leevawns/WHC512/main_v10/README.txt

void clearport(int port){
  id_card = (port-1)/64;
  id_ic = ((port-1)%64)/16;
  id_pin = (((port-1)%64)%16)+1;
  switch (id_card){
    case 0: 
      switch(id_ic){
      case 0: chip1.digitalWrite(0);chip1.pinMode(0); 
               break;
      case 1:  chip2.digitalWrite(0);chip2.pinMode(0);
               break;
      case 2:  chip3.digitalWrite(0);chip3.pinMode(0);
               break;
      case 3:  chip4.digitalWrite(0);chip4.pinMode(0);
         break;

      default:
         break;
        }break;
    case 1:
      switch(id_ic){
      case 0:  chip5.digitalWrite(0);chip5.pinMode(0);
               break;
      case 1: chip6.digitalWrite(0);chip6.pinMode(0); 
               break;
      case 2: chip7.digitalWrite(0);chip7.pinMode(0); 
               break;
      case 3: chip8.digitalWrite(0);chip8.pinMode(0); 
         break;
      default:
         break;    
    }break;
    case 2:
      switch(id_ic){
      case 0:  chip9.digitalWrite(0);chip9.pinMode(0);
               break;
      case 1: chip10.digitalWrite(0);chip10.pinMode(0); 
               break;
      case 2: chip11.digitalWrite(0);chip11.pinMode(0); 
               break;
      case 3: chip12.digitalWrite(0);chip12.pinMode(0); 
               break;
      default:
         break;    
    }break;
    case 3:
      switch(id_ic){
      case 0:  chip13.digitalWrite(0);chip13.pinMode(0);
               break;
      case 1: chip14.digitalWrite(0);chip14.pinMode(0); 
               break;
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
    }break;
    case 14:
      switch(id_ic){
       case 0:  chip57.digitalWrite(0);chip57.pinMode(0);
               break;
      case 1: chip58.digitalWrite(0);chip58.pinMode(0); 
               break;
      case 2: chip59.digitalWrite(0);chip59.pinMode(0); 
               break;
      case 3: chip60.digitalWrite(0);chip60.pinMode(0); 
               break;
        default:
         break;    
    }break;
    case 15:
      switch(id_ic){
      case 0:  chip61.digitalWrite(0);chip61.pinMode(0);
               break;
      case 1: chip62.digitalWrite(0);chip62.pinMode(0); 
               break;
      case 2: chip63.digitalWrite(0);chip63.pinMode(0); 
               break;
      case 3: chip64.digitalWrite(0);chip64.pinMode(0); 
               break;
      default:
               break;   
    }   */
default:
         break;     
  }
}
