leevawns/WHC512/PCB DESIGN BY A.CHUNG/HarnessChecker Pin Define.xlsx

Asignment of the I/O pins
STT | PIN No. | PIN Name | Speed | Direction | Initial state | Function | Connect to/from | Description
1 | 41 | PE5 | O1 | O | Push pull | Enable Card IO1 | PCB2 | L active
2 | 42 | PC0 | O1 | O | Push pull | Enable Card IO2 |  | L active
3 | 43 | PC1 | O3 | O | Push pull | Enable Card IO3 |  | L active
4 | 44 | PC2 | O3 | O | Push pull | Enable Card IO4 |  | L active
5 | 45 | PC3 | O3 | O | Push pull | Enable Card IO5 |  | L active
6 | 46 | PC4 | O3 | O | Push pull | Enable Card IO6 |  | L active
7 | 52 | PG0 | O1 | O | Push pull | Enable Card IO7 |  | L active
8 | 53 | PG1 | O1 | O | Push pull | Enable Card IO8 |  | L active
9 | 54 | PG2 | O1 | O | Push pull | Enable Card IO9 |  | L active
10 | 55 | PG3 | O1 | O | Push pull | Enable Card IO10 |  | L active
11 | 56 | PG4 | O1 | O | Push pull | Enable Card IO11 |  | L active
12 | 57 | PI0 | O1 | O | Push pull | Enable Card IO12 |  | L active
13 | 58 | PI1 | O1 | O | Push pull | Enable Card IO13 |  | L active
14 | 59 | PI2 | O1 | O | Push pull | Enable Card IO14 |  | L active
15 | 60 | PI3 | O1 | O | Push pull | Enable Card IO15 |  | L active
16 | 61 | PI4 | O1 | O | Push pull | Enable Card IO16 |  | L active
17 | 80 | PD7 |  | I | Wpu | Interrupt Card IO1 | PCB2 | H active
18 | 79 | PD6 |  | I | Wpu | Interrupt Card IO2 |  | H active
19 | 78 | PD5 |  | I | Wpu | Interrupt Card IO3 |  | H active
20 | 77 | PD4 |  | I | Wpu | Interrupt Card IO4 |  | H active
21 | 76 | PD3 |  | I | Wpu | Interrupt Card IO5 |  | H active
22 | 75 | PD2 |  | I | Wpu | Interrupt Card IO6 |  | H active
23 | 73 | PD0 |  | I | Wpu | Interrupt Card IO7 |  | H active
24 | 72 | PI7 |  | I | Wpu | Interrupt Card IO8 |  | H active
25 | 71 | PI6 |  | I | Wpu | Interrupt Card IO9 |  | H active
26 | 70 | PE0 |  | I | Wpu | Interrupt Card IO10 |  | H active
27 | 67 | PE3 |  | I | Wpu | Interrupt Card IO11 |  | H active
28 | 66 | PE4 |  | I | Wpu | Interrupt Card IO12 |  | H active
29 | 65 | PG7 |  | I | Wpu | Interrupt Card IO13 |  | H active
30 | 64 | PG6 |  | I | Wpu | Interrupt Card IO14 |  | H active
31 | 63 | PG5 |  | I | Wpu | Interrupt Card IO15 |  | H active
32 | 62 | PI5 |  | I | Wpu | Interrupt Card IO16 |  | H active
33 | 69 | PE1/I2C_SCL |  | O |  | I2C Clock | I2C Communication
34 | 68 | PE2/I2C_SDA |  | I/O |  | I2C Data
35 | 47 | PC5/SPI_SCK |  | O |  | SPI Clock | SPI Communication
36 | 50 | PC6/SPI_MOSI |  | O |  | SPI Master out/Slave in
37 | 51 | PC7/SPI_MISO |  | I |  | SPI Master in/Slave out
38 | 26 | PF0 | O1 | O | Push pull | Tape Control 1 | Tape | H active
39 | 27 | PB7 | O1 | O | Push pull | Tape Control 2 |  | H active
40 | 10 | PA4/USART_RX |  | I |  | USART receive | PC
41 | 11 | PA5/USART_TX |  | O |  | USART transmit
42 | 13 | PH0 | O3 | O | Push pull | Buzzer | PIN searh function | L active
43 | 14 | PH1 | O3 | I | Wpu | SW1 - Enter Pin search function |  | L active
44 | 15 | PH2 | O1 | O | Push pull | LED |  | H active
45 | 16 | PH3 | O1 | O | Push pull | Control Pin search function |  | L active
46 | 17 | PF7 | O1 | O |  | SPI1_SCK | SRAM - SPI Software
47 | 18 | PF6 | O1 | O |  | SPI1_SI
48 | 19 | PF5 |  | I |  | SPI1_SO
49 | 20 | PF4 | O1 | O |  | SPI1_CS |  | L active
50 | 28 | PB6 |  | I/O |  | Reserved
51 | 29 | PB5 |  | I/O
52 | 30 | PB4 |  | I/O
53 | 31 | PB3 |  | I/O
54 | 32 | PB2 |  | I/O
55 | 33 | PB1 |  | I/O
56 | 34 | PB0 |  | I/O
57 | 35 | PH4 |  | I/O
58 | 36 | PH5 |  | I/O
59 | 37 | PH6 |  | I/O
60 | 38 | PH7 |  | I/O
61 | 39 | PE7 |  | I/O
62 | 40 | PE6 |  | I/O
Output Speed:
O1 = Standard (up to 2MHz)
O3 = Fast/slow programmability with slow as default state after reset
