leevawns/WHC512/PCB DESIGN BY A.CHUNG/PartList_IOCar_64bit.xlsx

STT | Part Name | Reference Designator | Value | Tolerance | MAX Voltage | Chip Set | Maker | component kind | Quantity | Số lượng linh kiện trên 1 card
1 | GCM188R11C104JA01D | C1 | 0.1u | 5% | 16V | 1608 | Murata | Capacitor | 16 | GCM188R11C104JA01D | 16 | Tụ Ceramic 100nF / 50V / 0603
2 | GCM188R11C104JA01D | C2 | 0.1u | 5% | 16V | 1608 | Murata | Capacitor |  | 16SKV10M4*5.5 | 1 | Tụ nhôm 10uF / 16V
3 | GCM188R11C104JA01D | C3 | 0.1u | 5% | 16V | 1608 | Murata | Capacitor |  | MLZ2012M4R7W | 2
4 | GCM188R11C104JA01D | C4 | 0.1u | 5% | 16V | 1608 | Murata | Capacitor |  | FMN1T148 | 16
5 | GCM188R11C104JA01D | C5 | 0.1u | 5% | 16V | 1608 | Murata | Capacitor |  | FMP1T148 | 16
6 | GCM188R11C104JA01D | C6 | 0.1u | 5% | 16V | 1608 | Murata | Capacitor |  | MCP23S17-E/SO | 4
7 | GCM188R11C104JA01D | C7 | 0.1u | 5% | 16V | 1608 | Murata | Capacitor |  | CR1/16473JV | 24 | Điện trở 47k / 0603
8 | GCM188R11C104JA01D | C8 | 0.1u | 5% | 16V | 1608 | Murata | Capacitor |  | CR1/16103JV | 4 | Điện trở 10k / 0603
9 | GCM188R11C104JA01D | C9 | 0.1u | 5% | 16V | 1608 | Murata | Capacitor |  | CR1/16472JV | 64 | Điệntrở 4.7k / 0603
10 | GCM188R11C104JA01D | C10 | 0.1u | 5% | 16V | 1608 | Murata | Capacitor |  | PCN10-16P-2.54DS(72) | 1
11 | GCM188R11C104JA01D | C11 | 0.1u | 5% | 16V | 1608 | Murata | Capacitor |  | XG4A-6434 | 1
12 | GCM188R11C104JA01D | C12 | 0.1u | 5% | 16V | 1608 | Murata | Capacitor |  | 4816P-1-101LF | 8
13 | GCM188R11C104JA01D | C13 | 0.1u | 5% | 16V | 1608 | Murata | Capacitor
14 | GCM188R11C104JA01D | C14 | 0.1u | 5% | 16V | 1608 | Murata | Capacitor
15 | GCM188R11C104JA01D | C15 | 0.1u | 5% | 16V | 1608 | Murata | Capacitor
16 | GCM188R11C104JA01D | C16 | 0.1u | 5% | 16V | 1608 | Murata | Capacitor
17 | 16SKV10M4*5.5 | C17 | 10u | ・\ | 16V | ・\ | Rubicon | Capacitor | 0
18 | MLZ2012M4R7W | L1 | 4.7uH | 20% | - | 2125 | TDK | Coil | 2
19 | MLZ2012M4R7W | L2 | 4.7uH | 20% | - | 2125 | TDK | Coil
20 | FMN1T148 | D10A |  |  |  | SC-74A | Rohm | Diode | 16
21 | FMP1T148 | D10B |  |  |  | SC-74A | Rohm | Diode | 16
22 | FMN1T148 | D11A |  |  |  | SC-74A | Rohm | Diode | 16
23 | FMP1T148 | D11B |  |  |  | SC-74A | Rohm | Diode
24 | FMN1T148 | D12A |  |  |  | SC-74A | Rohm | Diode
25 | FMP1T148 | D12B |  |  |  | SC-74A | Rohm | Diode
26 | FMN1T148 | D13A |  |  |  | SC-74A | Rohm | Diode
27 | FMP1T148 | D13B |  |  |  | SC-74A | Rohm | Diode
28 | FMN1T148 | D14A |  |  |  | SC-74A | Rohm | Diode
29 | FMP1T148 | D14B |  |  |  | SC-74A | Rohm | Diode
30 | FMN1T148 | D15A |  |  |  | SC-74A | Rohm | Diode
31 | FMP1T148 | D15B |  |  |  | SC-74A | Rohm | Diode
32 | FMN1T148 | D16A |  |  |  | SC-74A | Rohm | Diode
33 | FMP1T148 | D16B |  |  |  | SC-74A | Rohm | Diode
34 | FMN1T148 | D1A |  |  |  | SC-74A | Rohm | Diode
35 | FMP1T148 | D1B |  |  |  | SC-74A | Rohm | Diode
36 | FMN1T148 | D2A |  |  |  | SC-74A | Rohm | Diode
37 | FMP1T148 | D2B |  |  |  | SC-74A | Rohm | Diode
38 | FMN1T148 | D3A |  |  |  | SC-74A | Rohm | Diode
39 | FMP1T148 | D3B |  |  |  | SC-74A | Rohm | Diode
40 | FMN1T148 | D4A |  |  |  | SC-74A | Rohm | Diode
41 | FMP1T148 | D4B |  |  |  | SC-74A | Rohm | Diode
42 | FMN1T148 | D5A |  |  |  | SC-74A | Rohm | Diode
43 | FMP1T148 | D5B |  |  |  | SC-74A | Rohm | Diode
44 | FMN1T148 | D6A |  |  |  | SC-74A | Rohm | Diode
45 | FMP1T148 | D6B |  |  |  | SC-74A | Rohm | Diode
46 | FMN1T148 | D7A |  |  |  | SC-74A | Rohm | Diode
47 | FMP1T148 | D7B |  |  |  | SC-74A | Rohm | Diode
48 | FMN1T148 | D8A |  |  |  | SC-74A | Rohm | Diode
49 | FMP1T148 | D8B |  |  |  | SC-74A | Rohm | Diode
50 | FMN1T148 | D9A |  |  |  | SC-74A | Rohm | Diode
51 | FMP1T148 | D9B |  |  |  | SC-74A | Rohm | Diode
52 | MCP23S17-E/SO | IC1 | - | - | - | SOIC | Microchip | IC | 4
53 | MCP23S17-E/SO | IC2 | - | - | - | SOIC | Microchip | IC
54 | MCP23S17-E/SO | IC3 | - | - | - | SOIC | Microchip | IC
55 | MCP23S17-E/SO | IC4 | - | - | - | SOIC | Microchip | IC
56 | CR1/16473JV | R1 | 47k | 5% | ・\ | 1608 | HOKURIKU | Resistor | 24
57 | CR1/16473JV | R2 | 47k | 5% | ・\ | 1608 | HOKURIKU | Resistor
58 | CR1/16473JV | R3 | 47k | 5% | ・\ | 1608 | HOKURIKU | Resistor
59 | CR1/16473JV | R4 | 47k | 5% | ・\ | 1608 | HOKURIKU | Resistor
60 | CR1/16473JV | R5 | 47k | 5% | ・\ | 1608 | HOKURIKU | Resistor
61 | CR1/16473JV | R6 | 47k | 5% | ・\ | 1608 | HOKURIKU | Resistor
62 | CR1/16473JV | R7 | 47k | 5% | ・\ | 1608 | HOKURIKU | Resistor
63 | CR1/16473JV | R8 | 47k | 5% | ・\ | 1608 | HOKURIKU | Resistor
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
124 | CR1/16472JV | R69 | 4.7k | 5% | 50V | 1608 | HOKURIKU | Resistor
125 | CR1/16472JV | R70 | 4.7k | 5% | 50V | 1608 | HOKURIKU | Resistor
126 | CR1/16472JV | R71 | 4.7k | 5% | 50V | 1608 | HOKURIKU | Resistor
127 | CR1/16472JV | R72 | 4.7k | 5% | 50V | 1608 | HOKURIKU | Resistor
128 | CR1/16472JV | R73 | 4.7k | 5% | 50V | 1608 | HOKURIKU | Resistor
129 | CR1/16472JV | R74 | 4.7k | 5% | 50V | 1608 | HOKURIKU | Resistor
130 | CR1/16472JV | R75 | 4.7k | 5% | 50V | 1608 | HOKURIKU | Resistor
131 | CR1/16472JV | R76 | 4.7k | 5% | 50V | 1608 | HOKURIKU | Resistor
132 | CR1/16472JV | R77 | 4.7k | 5% | 50V | 1608 | HOKURIKU | Resistor
133 | CR1/16472JV | R78 | 4.7k | 5% | 50V | 1608 | HOKURIKU | Resistor
134 | CR1/16472JV | R79 | 4.7k | 5% | 50V | 1608 | HOKURIKU | Resistor
135 | CR1/16472JV | R80 | 4.7k | 5% | 50V | 1608 | HOKURIKU | Resistor
136 | CR1/16472JV | R81 | 4.7k | 5% | 50V | 1608 | HOKURIKU | Resistor
137 | CR1/16472JV | R82 | 4.7k | 5% | 50V | 1608 | HOKURIKU | Resistor
138 | CR1/16472JV | R83 | 4.7k | 5% | 50V | 1608 | HOKURIKU | Resistor
139 | CR1/16472JV | R84 | 4.7k | 5% | 50V | 1608 | HOKURIKU | Resistor
140 | CR1/16472JV | R85 | 4.7k | 5% | 50V | 1608 | HOKURIKU | Resistor
141 | CR1/16472JV | R86 | 4.7k | 5% | 50V | 1608 | HOKURIKU | Resistor
142 | CR1/16472JV | R87 | 4.7k | 5% | 50V | 1608 | HOKURIKU | Resistor
143 | CR1/16472JV | R88 | 4.7k | 5% | 50V | 1608 | HOKURIKU | Resistor
144 | CR1/16472JV | R89 | 4.7k | 5% | 50V | 1608 | HOKURIKU | Resistor
145 | CR1/16472JV | R90 | 4.7k | 5% | 50V | 1608 | HOKURIKU | Resistor
146 | CR1/16472JV | R91 | 4.7k | 5% | 50V | 1608 | HOKURIKU | Resistor
147 | CR1/16472JV | R92 | 4.7k | 5% | 50V | 1608 | HOKURIKU | Resistor
148 | PCN10-16P-2.54DS(72) | CN1 |  |  |  |  | HIROSE | Connector | 1
149 | XG4A-6434 | CN2 | ・\ | ・\ | ・\ | ・\ | OMRON | Connector | 1
150 | 4816P-1-101LF | RA1 | 100 | 2% | - | - | BOURNS | Resistor | 8
151 | 4816P-1-101LF | RA2 | 100 | 2% | - | - | BOURNS | Resistor
152 | 4816P-1-101LF | RA3 | 100 | 2% | - | - | BOURNS | Resistor
153 | 4816P-1-101LF | RA4 | 100 | 2% | - | - | BOURNS | Resistor
154 | 4816P-1-101LF | RA5 | 100 | 2% | - | - | BOURNS | Resistor
155 | 4816P-1-101LF | RA6 | 100 | 2% | - | - | BOURNS | Resistor
156 | 4816P-1-101LF | RA7 | 100 | 2% | - | - | BOURNS | Resistor
157 | 4816P-1-101LF | RA8 | 100 | 2% | - | - | BOURNS | Resistor
