leevawns/WHC512/PCB DESIGN BY A.CHUNG/PartList_MAIN.xlsx

STT | Part Name | Reference Designator | Value | Tolerance | MAX Voltage | Chip Set | Maker | component kind | Quantity | Số lượng linh kiện trên 1 card
1 | GCM188R11C104JA01D | C2 | 0.1u | 5% | 16V | 1608 | Murata | Capacitor | 16 | GCM188R11C104JA01D | 16 | Tụ Ceramic 100nF / 50V / 0603
2 | GCM188R11C104JA01D | C6 | 0.1u | 5% | 16V | 1608 | Murata | Capacitor |  | EEEFK1C101P | 1 | Tụ nhôm 100uF /16V
3 | GCM188R11C104JA01D | C7 | 0.1u | 5% | 16V | 1608 | Murata | Capacitor |  | MCP23017-E/SO | 8
4 | GCM188R11C104JA01D | C13 | 0.1u | 5% | 16V | 1608 | Murata | Capacitor |  | CR1/16473JV | 24 | Điện trở 47k / 0603
5 | GCM188R11C104JA01D | C14 | 0.1u | 5% | 16V | 1608 | Murata | Capacitor |  | CR1/16103JV | 8 | Điện trở 10k / 0603
6 | GCM188R11C104JA01D | C18 | 0.1u | 5% | 16V | 1608 | Murata | Capacitor |  | 61204021621 | 1
7 | GCM188R11C104JA01D | C19 | 0.1u | 5% | 16V | 1608 | Murata | Capacitor |  | KLS1-2.54-02-S | 1
8 | GCM188R11C104JA01D | C21 | 0.1u | 5% | 16V | 1608 | Murata | Capacitor |  | 2-534206-0 | 1
9 | GCM188R11C104JA01D | C22 | 0.1u | 5% | 16V | 1608 | Murata | Capacitor |  | PCN10C-16S-2.54DSA(72) | 16
10 | GCM188R11C104JA01D | C24 | 0.1u | 5% | 16V | 1608 | Murata | Capacitor
11 | GCM188R11C104JA01D | C25 | 0.1u | 5% | 16V | 1608 | Murata | Capacitor
12 | GCM188R11C104JA01D | C26 | 0.1u | 5% | 16V | 1608 | Murata | Capacitor
13 | GCM188R11C104JA01D | C27 | 0.1u | 5% | 16V | 1608 | Murata | Capacitor
14 | GCM188R11C104JA01D | C32 | 0.1u | 5% | 16V | 1608 | Murata | Capacitor
15 | GCM188R11C104JA01D | C34 | 0.1u | 5% | 16V | 1608 | Murata | Capacitor
16 | GCM188R11C104JA01D | C37 | 0.1u | 5% | 16V | 1608 | Murata | Capacitor
17 | EEEFK1C101P | C38 | 100u | 20% | 16V | ・\ | Panasonic | Capacitor | 1
18 | MCP23017-E/SO | IC1 | - | - | - | SOIC | Microchip | IC | 8
19 | MCP23017-E/SO | IC2 | - | - | - | SOIC | Microchip | IC
20 | MCP23017-E/SO | IC3 | - | - | - | SOIC | Microchip | IC
21 | MCP23017-E/SO | IC4 | - | - | - | SOIC | Microchip | IC
22 | MCP23017-E/SO | IC5 | - | - | - | SOIC | Microchip | IC
23 | MCP23017-E/SO | IC6 | - | - | - | SOIC | Microchip | IC
24 | MCP23017-E/SO | IC7 | - | - | - | SOIC | Microchip | IC
25 | MCP23017-E/SO | IC8 | - | - | - | SOIC | Microchip | IC
26 | CR1/16473JV | R1 | 47k | 5% | ・\ | 1608 | HOKURIKU | Resistor | 24
27 | CR1/16473JV | R2 | 47k | 5% | ・\ | 1608 | HOKURIKU | Resistor
28 | CR1/16473JV | R3 | 47k | 5% | ・\ | 1608 | HOKURIKU | Resistor
29 | CR1/16103JV | R4 | 10k | 5% | 50V | 1608 | HOKURIKU | Resistor | 8
30 | CR1/16473JV | R5 | 47k | 5% | ・\ | 1608 | HOKURIKU | Resistor
31 | CR1/16473JV | R6 | 47k | 5% | ・\ | 1608 | HOKURIKU | Resistor
32 | CR1/16473JV | R7 | 47k | 5% | ・\ | 1608 | HOKURIKU | Resistor
33 | CR1/16103JV | R14 | 10k | 5% | 50V | 1608 | HOKURIKU | Resistor
34 | CR1/16473JV | R19 | 47k | 5% | ・\ | 1608 | HOKURIKU | Resistor
35 | CR1/16473JV | R20 | 47k | 5% | ・\ | 1608 | HOKURIKU | Resistor
36 | CR1/16473JV | R21 | 47k | 5% | ・\ | 1608 | HOKURIKU | Resistor
37 | CR1/16103JV | R24 | 10k | 5% | 50V | 1608 | HOKURIKU | Resistor
38 | CR1/16473JV | R29 | 47k | 5% | ・\ | 1608 | HOKURIKU | Resistor
39 | CR1/16473JV | R30 | 47k | 5% | ・\ | 1608 | HOKURIKU | Resistor
40 | CR1/16473JV | R31 | 47k | 5% | ・\ | 1608 | HOKURIKU | Resistor
41 | CR1/16103JV | R36 | 10k | 5% | 50V | 1608 | HOKURIKU | Resistor
42 | CR1/16473JV | R46 | 47k | 5% | ・\ | 1608 | HOKURIKU | Resistor
43 | CR1/16473JV | R47 | 47k | 5% | ・\ | 1608 | HOKURIKU | Resistor
44 | CR1/16473JV | R48 | 47k | 5% | ・\ | 1608 | HOKURIKU | Resistor
45 | CR1/16103JV | R64 | 10k | 5% | 50V | 1608 | HOKURIKU | Resistor
46 | CR1/16473JV | R65 | 47k | 5% | ・\ | 1608 | HOKURIKU | Resistor
47 | CR1/16473JV | R66 | 47k | 5% | ・\ | 1608 | HOKURIKU | Resistor
48 | CR1/16473JV | R67 | 47k | 5% | ・\ | 1608 | HOKURIKU | Resistor
49 | CR1/16103JV | R69 | 10k | 5% | 50V | 1608 | HOKURIKU | Resistor
50 | CR1/16473JV | R75 | 47k | 5% | ・\ | 1608 | HOKURIKU | Resistor
51 | CR1/16473JV | R76 | 47k | 5% | ・\ | 1608 | HOKURIKU | Resistor
52 | CR1/16473JV | R77 | 47k | 5% | ・\ | 1608 | HOKURIKU | Resistor
53 | CR1/16103JV | R78 | 10k | 5% | 50V | 1608 | HOKURIKU | Resistor
54 | CR1/16473JV | R79 | 47k | 5% | ・\ | 1608 | HOKURIKU | Resistor
55 | CR1/16473JV | R80 | 47k | 5% | ・\ | 1608 | HOKURIKU | Resistor
56 | CR1/16473JV | R81 | 47k | 5% | ・\ | 1608 | HOKURIKU | Resistor
57 | CR1/16103JV | R82 | 10k | 5% | 50V | 1608 | HOKURIKU | Resistor
58 | 61204021621 | CN1 | - | - | - | - | WURTH | Connector | 1
59 | KLS1-2.54-02-S | CN2 | - | - | - | - | KLS | Connector | 1
60 | 2-534206-0 | CN3 | - | - | - | - | TE | Connector | 1
61 | PCN10C-16S-2.54DSA(72) | P1 |  |  |  |  | HIROSE | Connector | 16
62 | PCN10C-16S-2.54DSA(72) | P2 |  |  |  |  | HIROSE | Connector
63 | PCN10C-16S-2.54DSA(72) | P3 |  |  |  |  | HIROSE | Connector
64 | PCN10C-16S-2.54DSA(72) | P4 |  |  |  |  | HIROSE | Connector
65 | PCN10C-16S-2.54DSA(72) | P5 |  |  |  |  | HIROSE | Connector
66 | PCN10C-16S-2.54DSA(72) | P6 |  |  |  |  | HIROSE | Connector
67 | PCN10C-16S-2.54DSA(72) | P7 |  |  |  |  | HIROSE | Connector
68 | PCN10C-16S-2.54DSA(72) | P8 |  |  |  |  | HIROSE | Connector
69 | PCN10C-16S-2.54DSA(72) | P9 |  |  |  |  | HIROSE | Connector
70 | PCN10C-16S-2.54DSA(72) | P10 |  |  |  |  | HIROSE | Connector
71 | PCN10C-16S-2.54DSA(72) | P11 |  |  |  |  | HIROSE | Connector
72 | PCN10C-16S-2.54DSA(72) | P12 |  |  |  |  | HIROSE | Connector
73 | PCN10C-16S-2.54DSA(72) | P13 |  |  |  |  | HIROSE | Connector
74 | PCN10C-16S-2.54DSA(72) | P14 |  |  |  |  | HIROSE | Connector
75 | PCN10C-16S-2.54DSA(72) | P15 |  |  |  |  | HIROSE | Connector
76 | PCN10C-16S-2.54DSA(72) | P16 |  |  |  |  | HIROSE | Connector
