leevawns/WHC512/PCB DESIGN BY A.CHUNG/PCB1-MCU.pdf

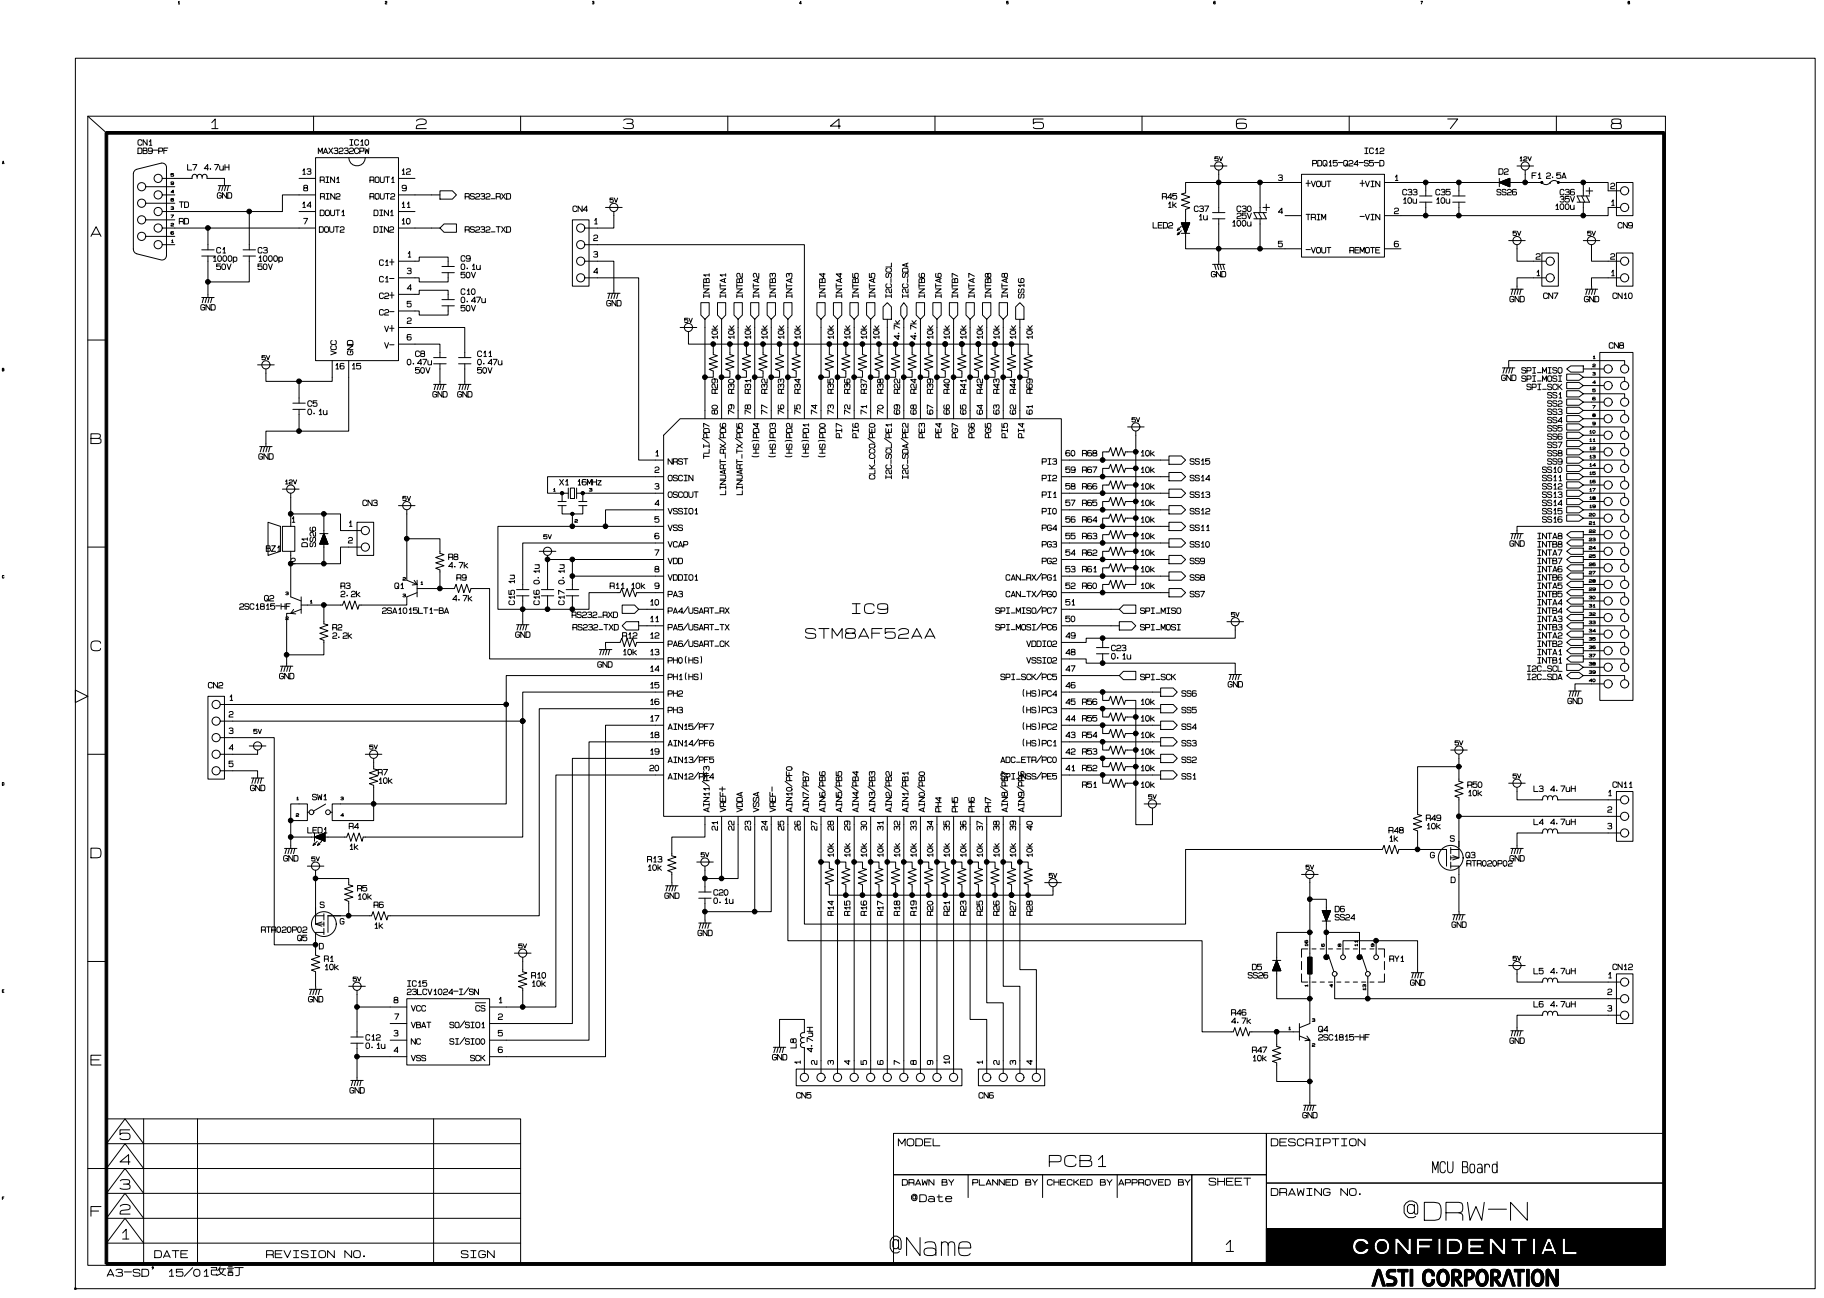
[picture p1: page 1]
