leevawns/WHC512/PCB DESIGN BY A.CHUNG/PCB2-Control.pdf

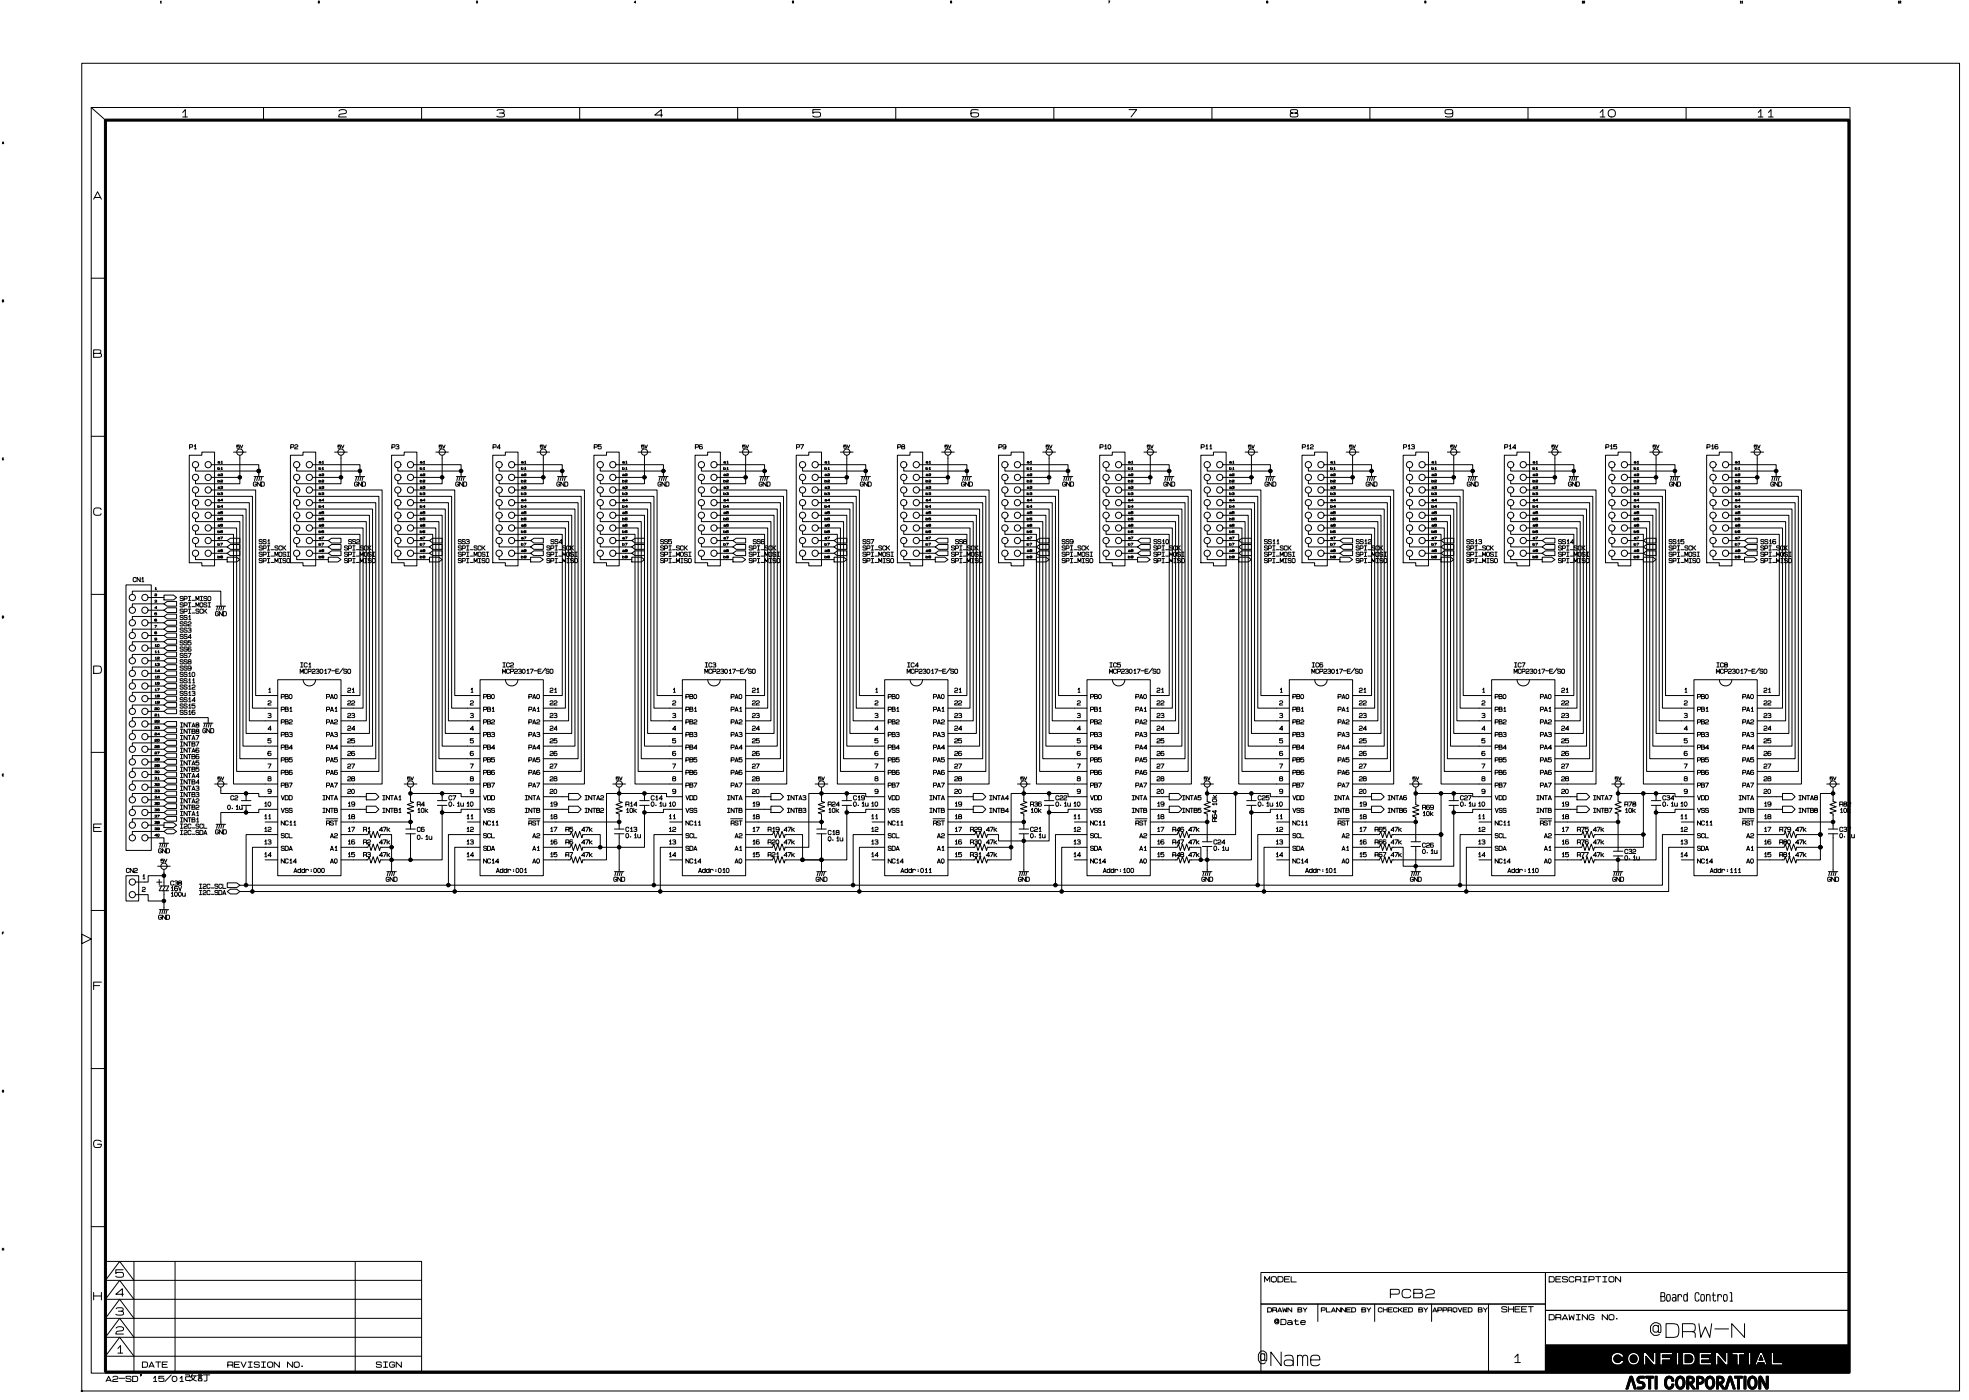
[picture p2: page 1]
