leevawns/WHC512/PCB DESIGN BY A.CHUNG/PCB3-Card IO 64Bit.pdf

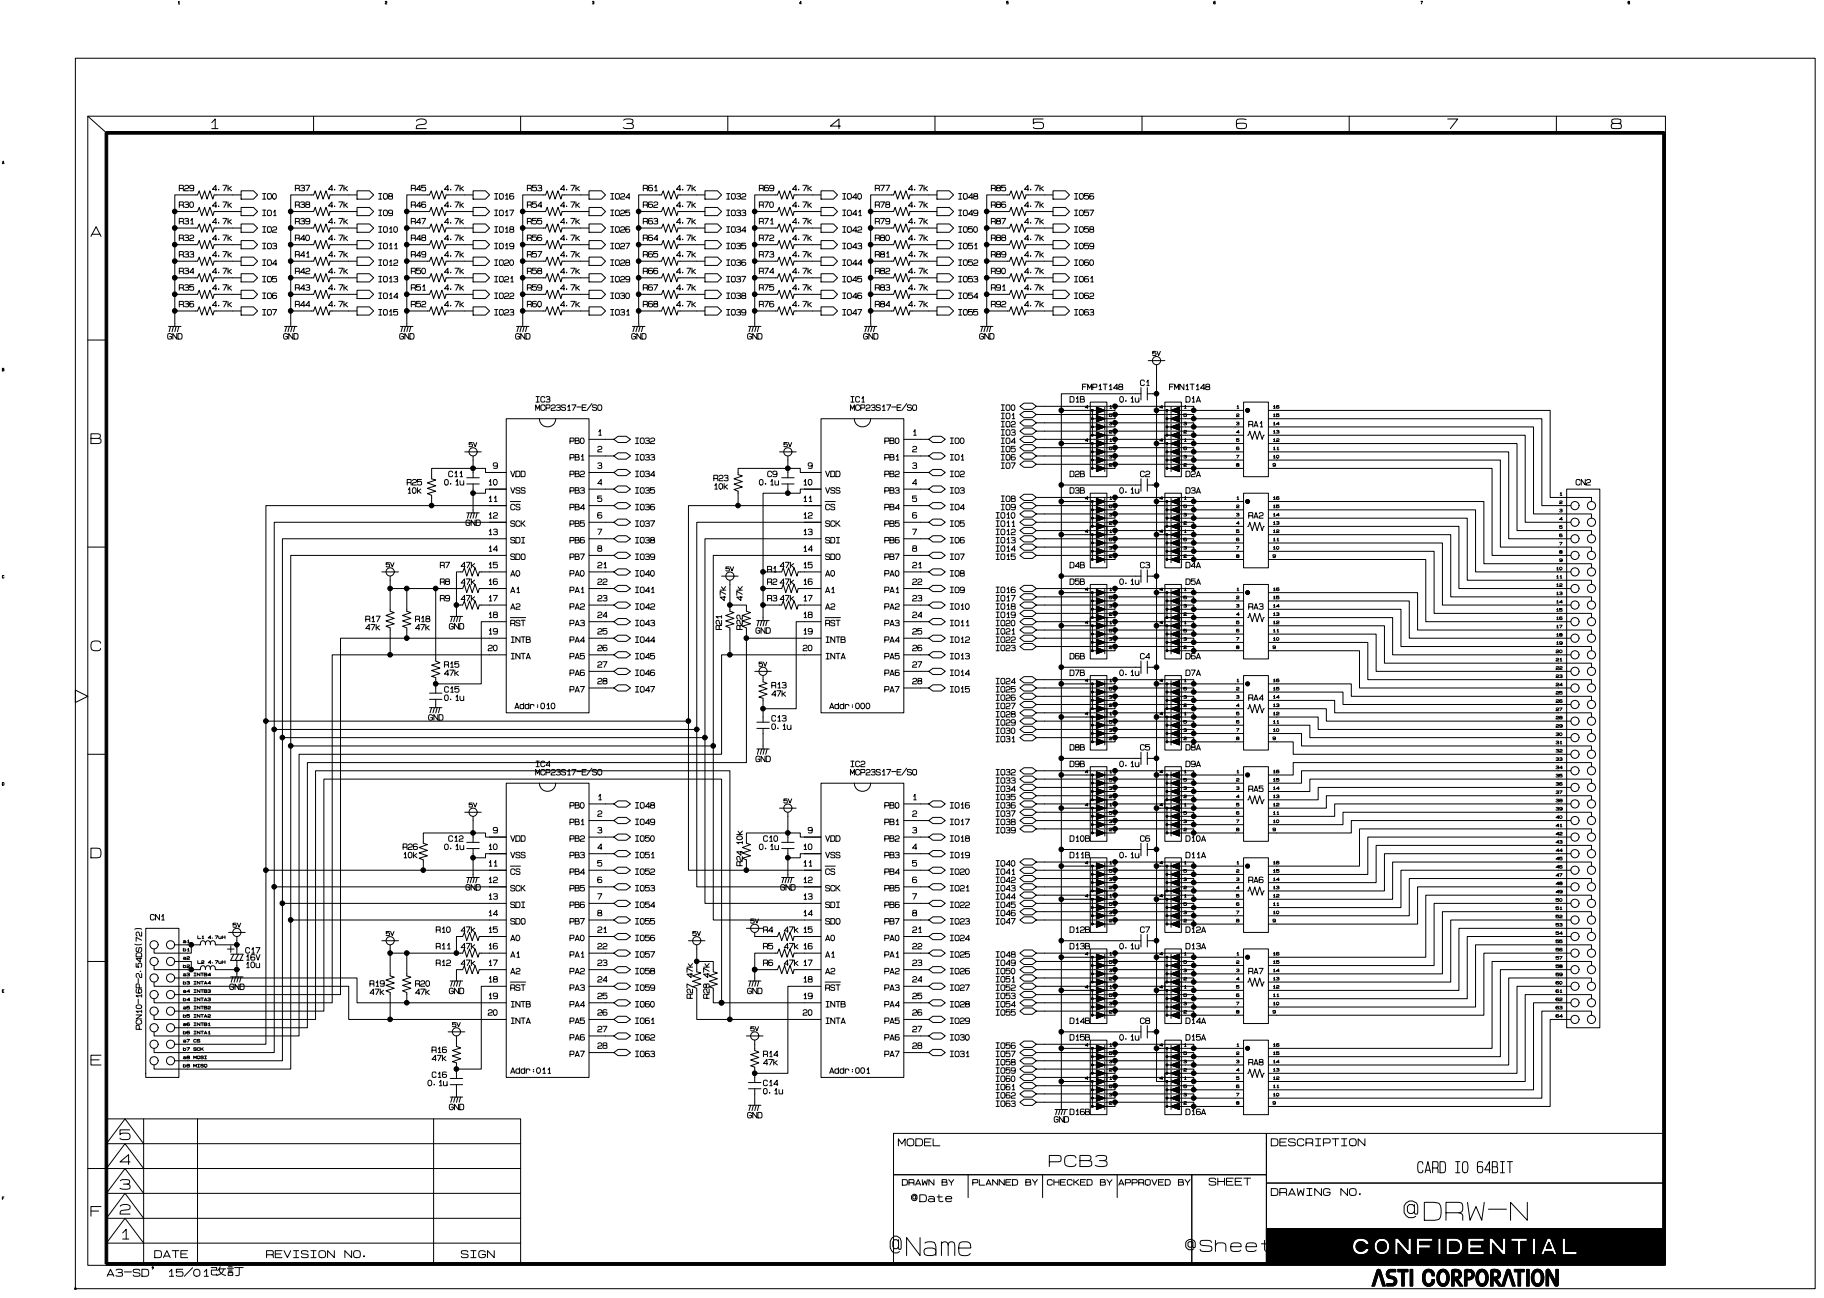
[picture p3: page 1]
