leevawns/WHC512/PCB DESIGN BY A.CHUNG/Wire harness schematic - v2/Arduino_Mega2560_R5.pdf

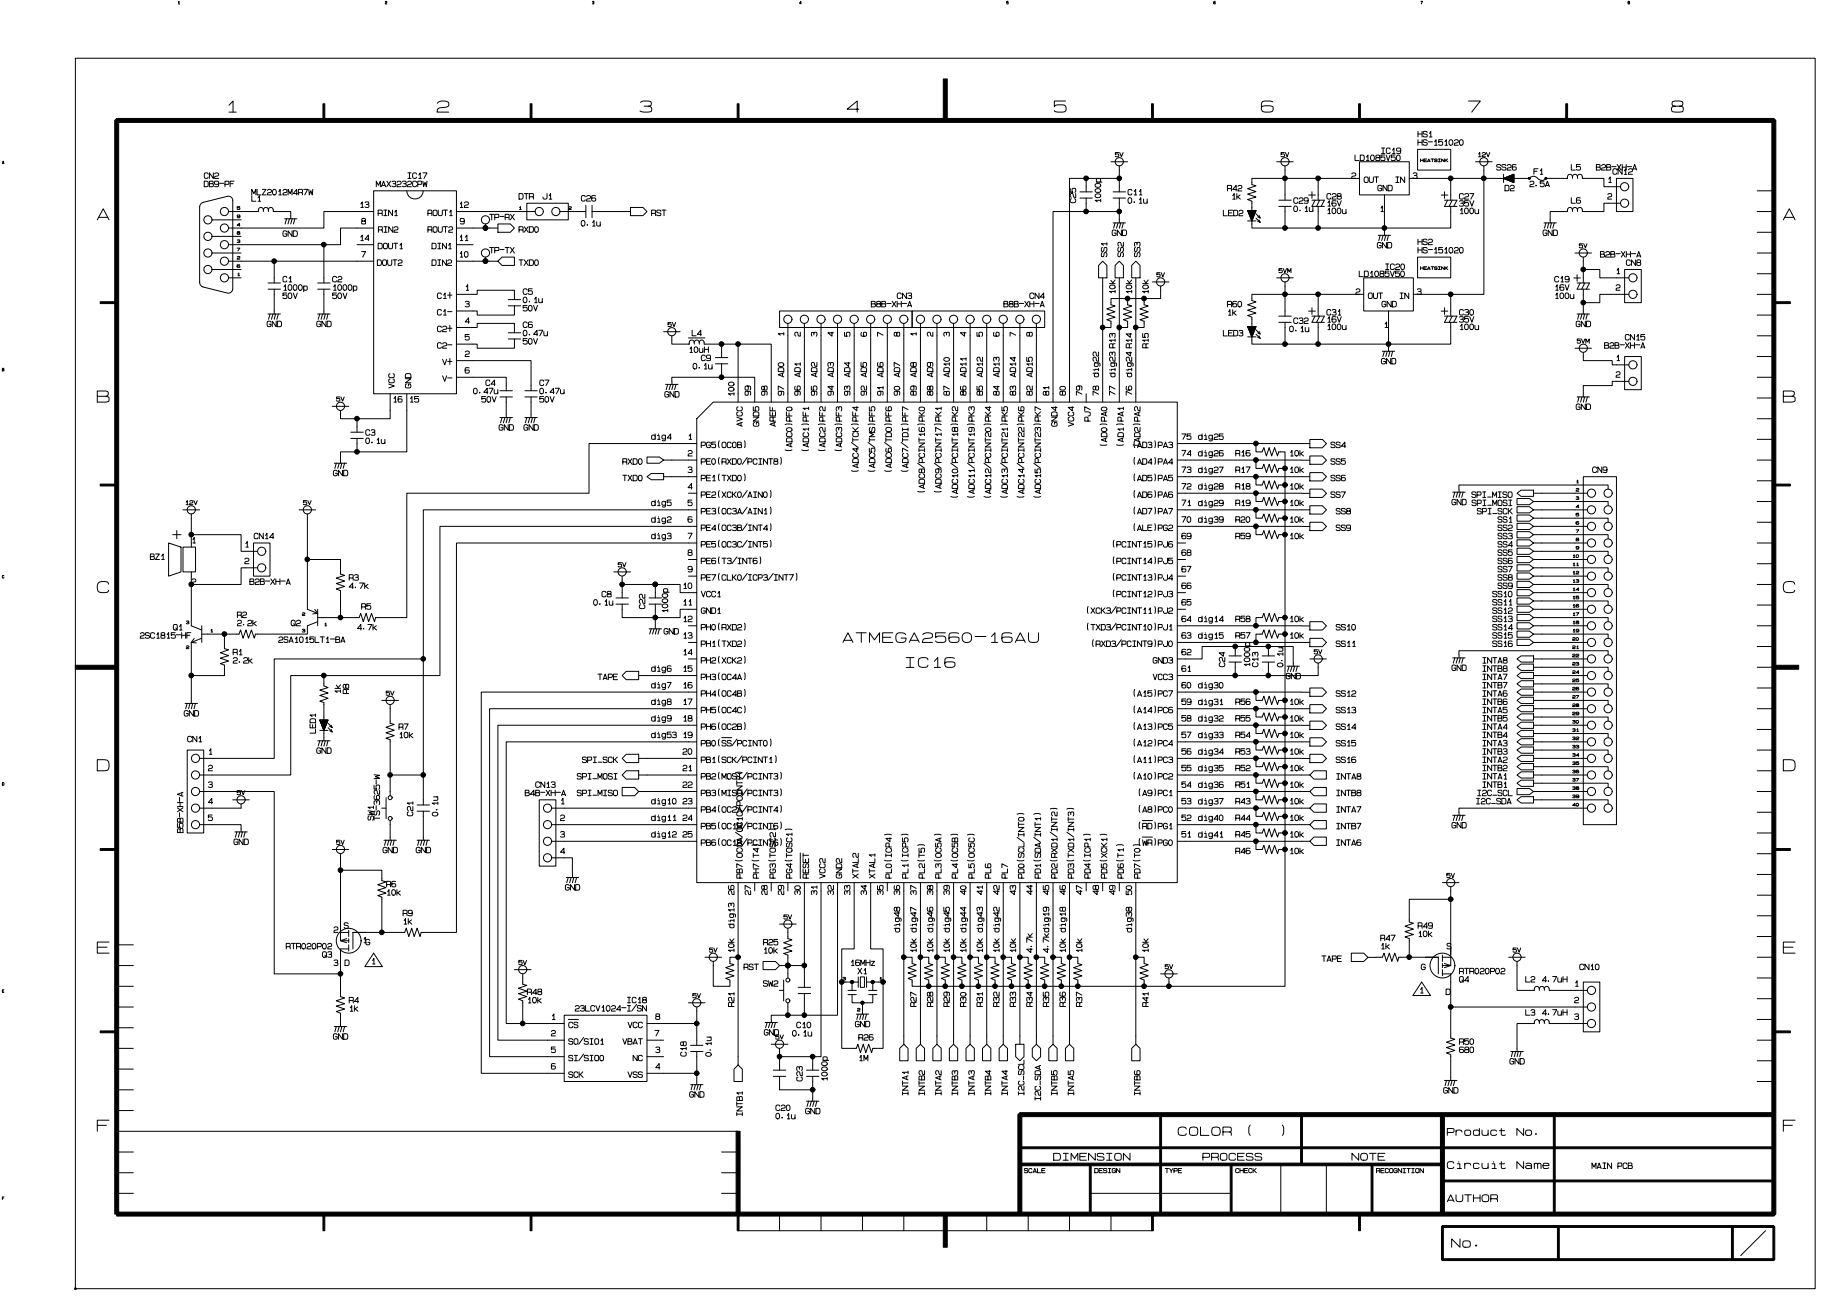
[picture p4: page 1]
