leevawns/WHC512/PCB DESIGN BY A.CHUNG/Wire harness schematic - v2/CARD IO 64BIT_REV2.pdf

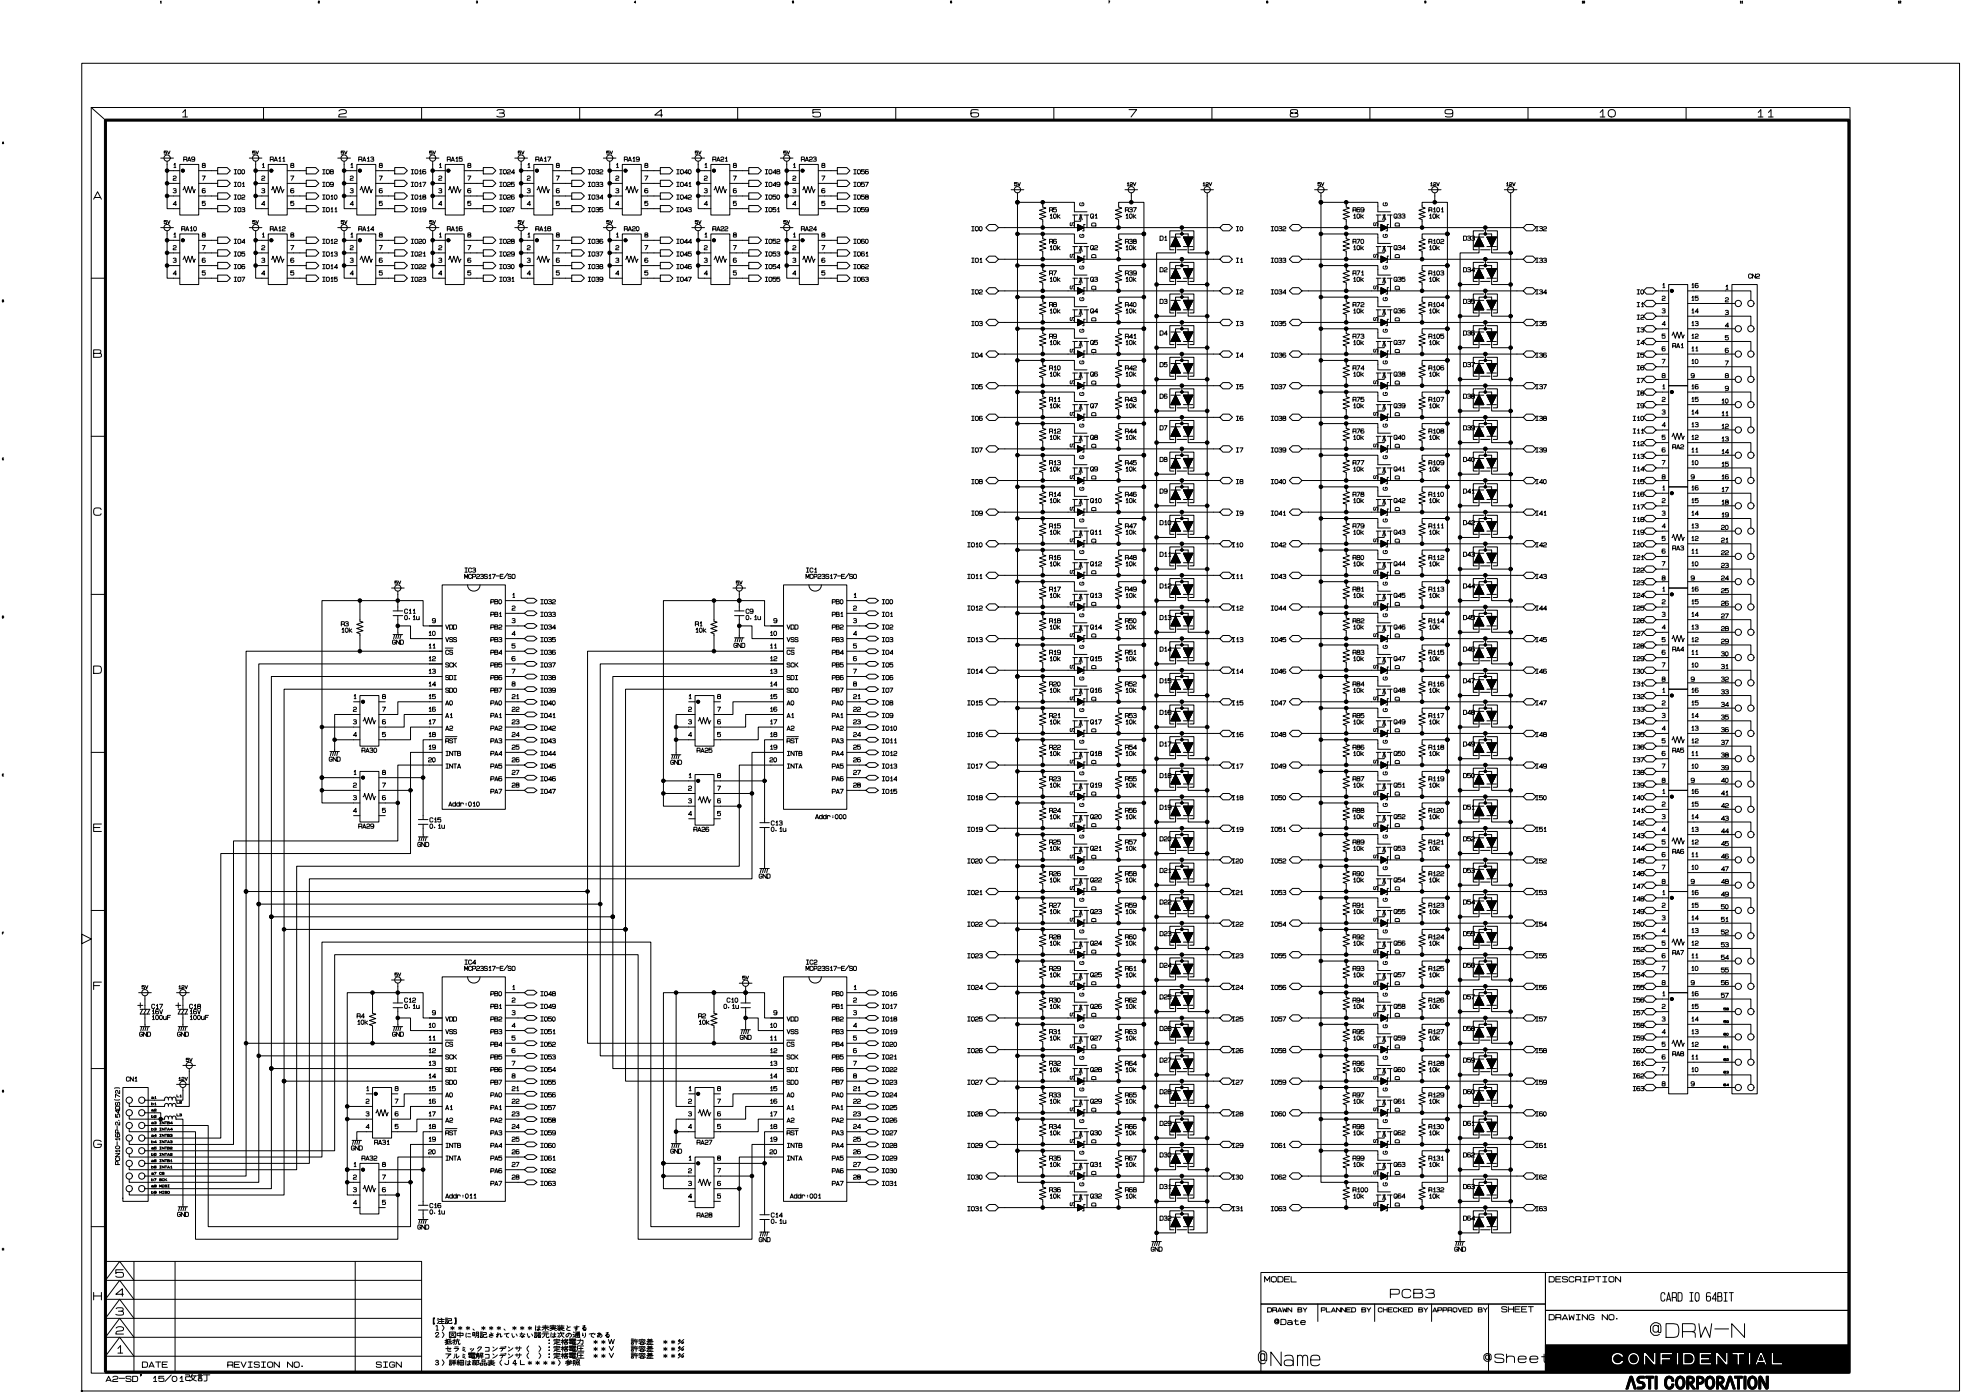
[picture p5: page 1]
