leevawns/WHC512/PCB DESIGN BY A.CHUNG/Wire harness schematic - v2/MAIN PCB_REV2.pdf

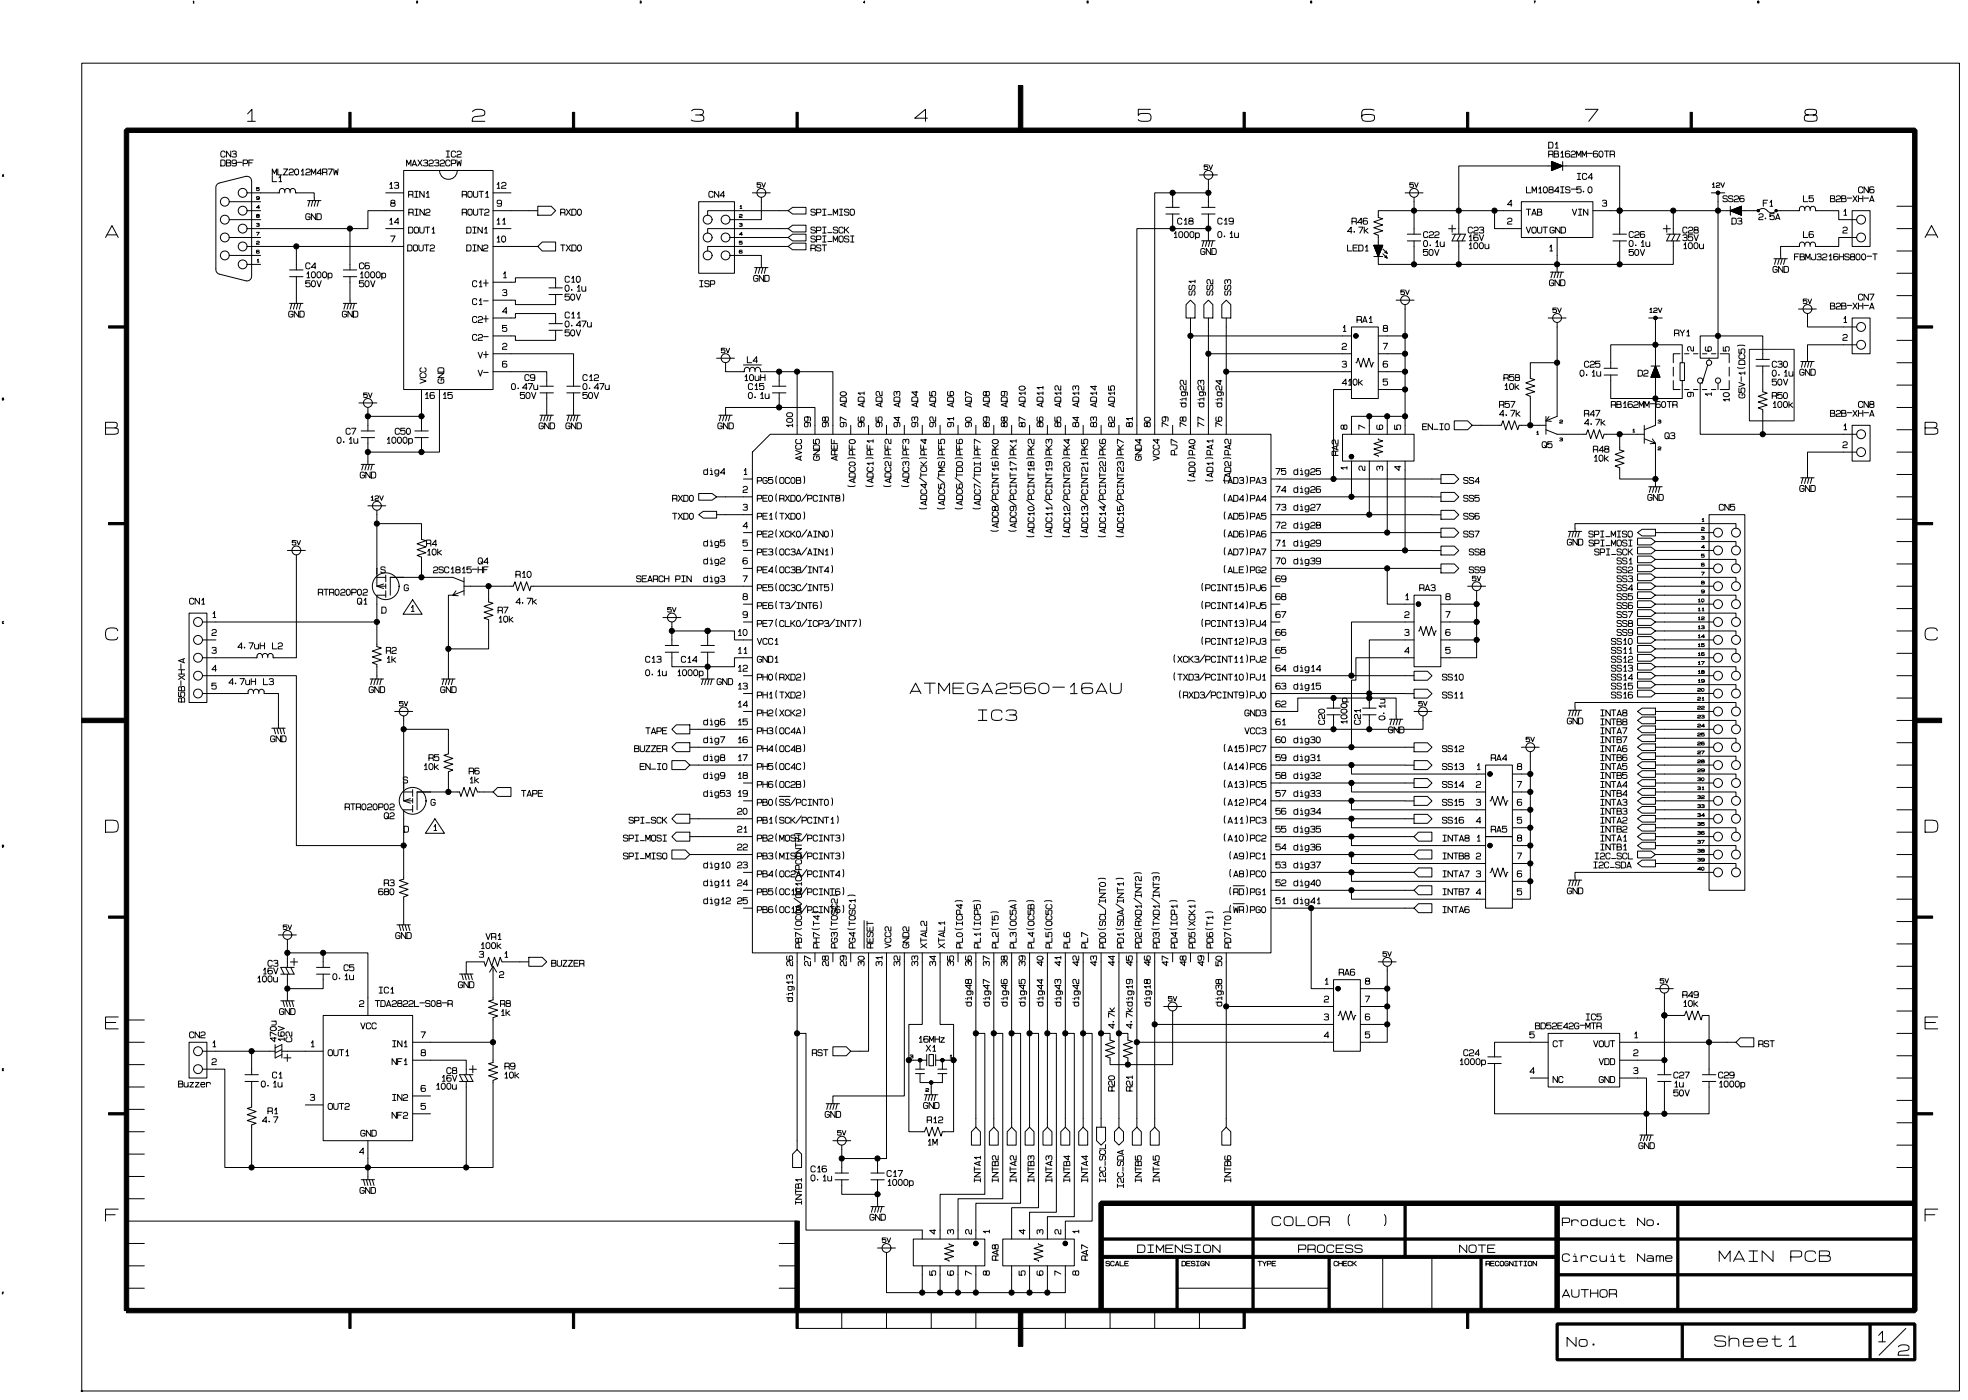
[picture p6: page 1]

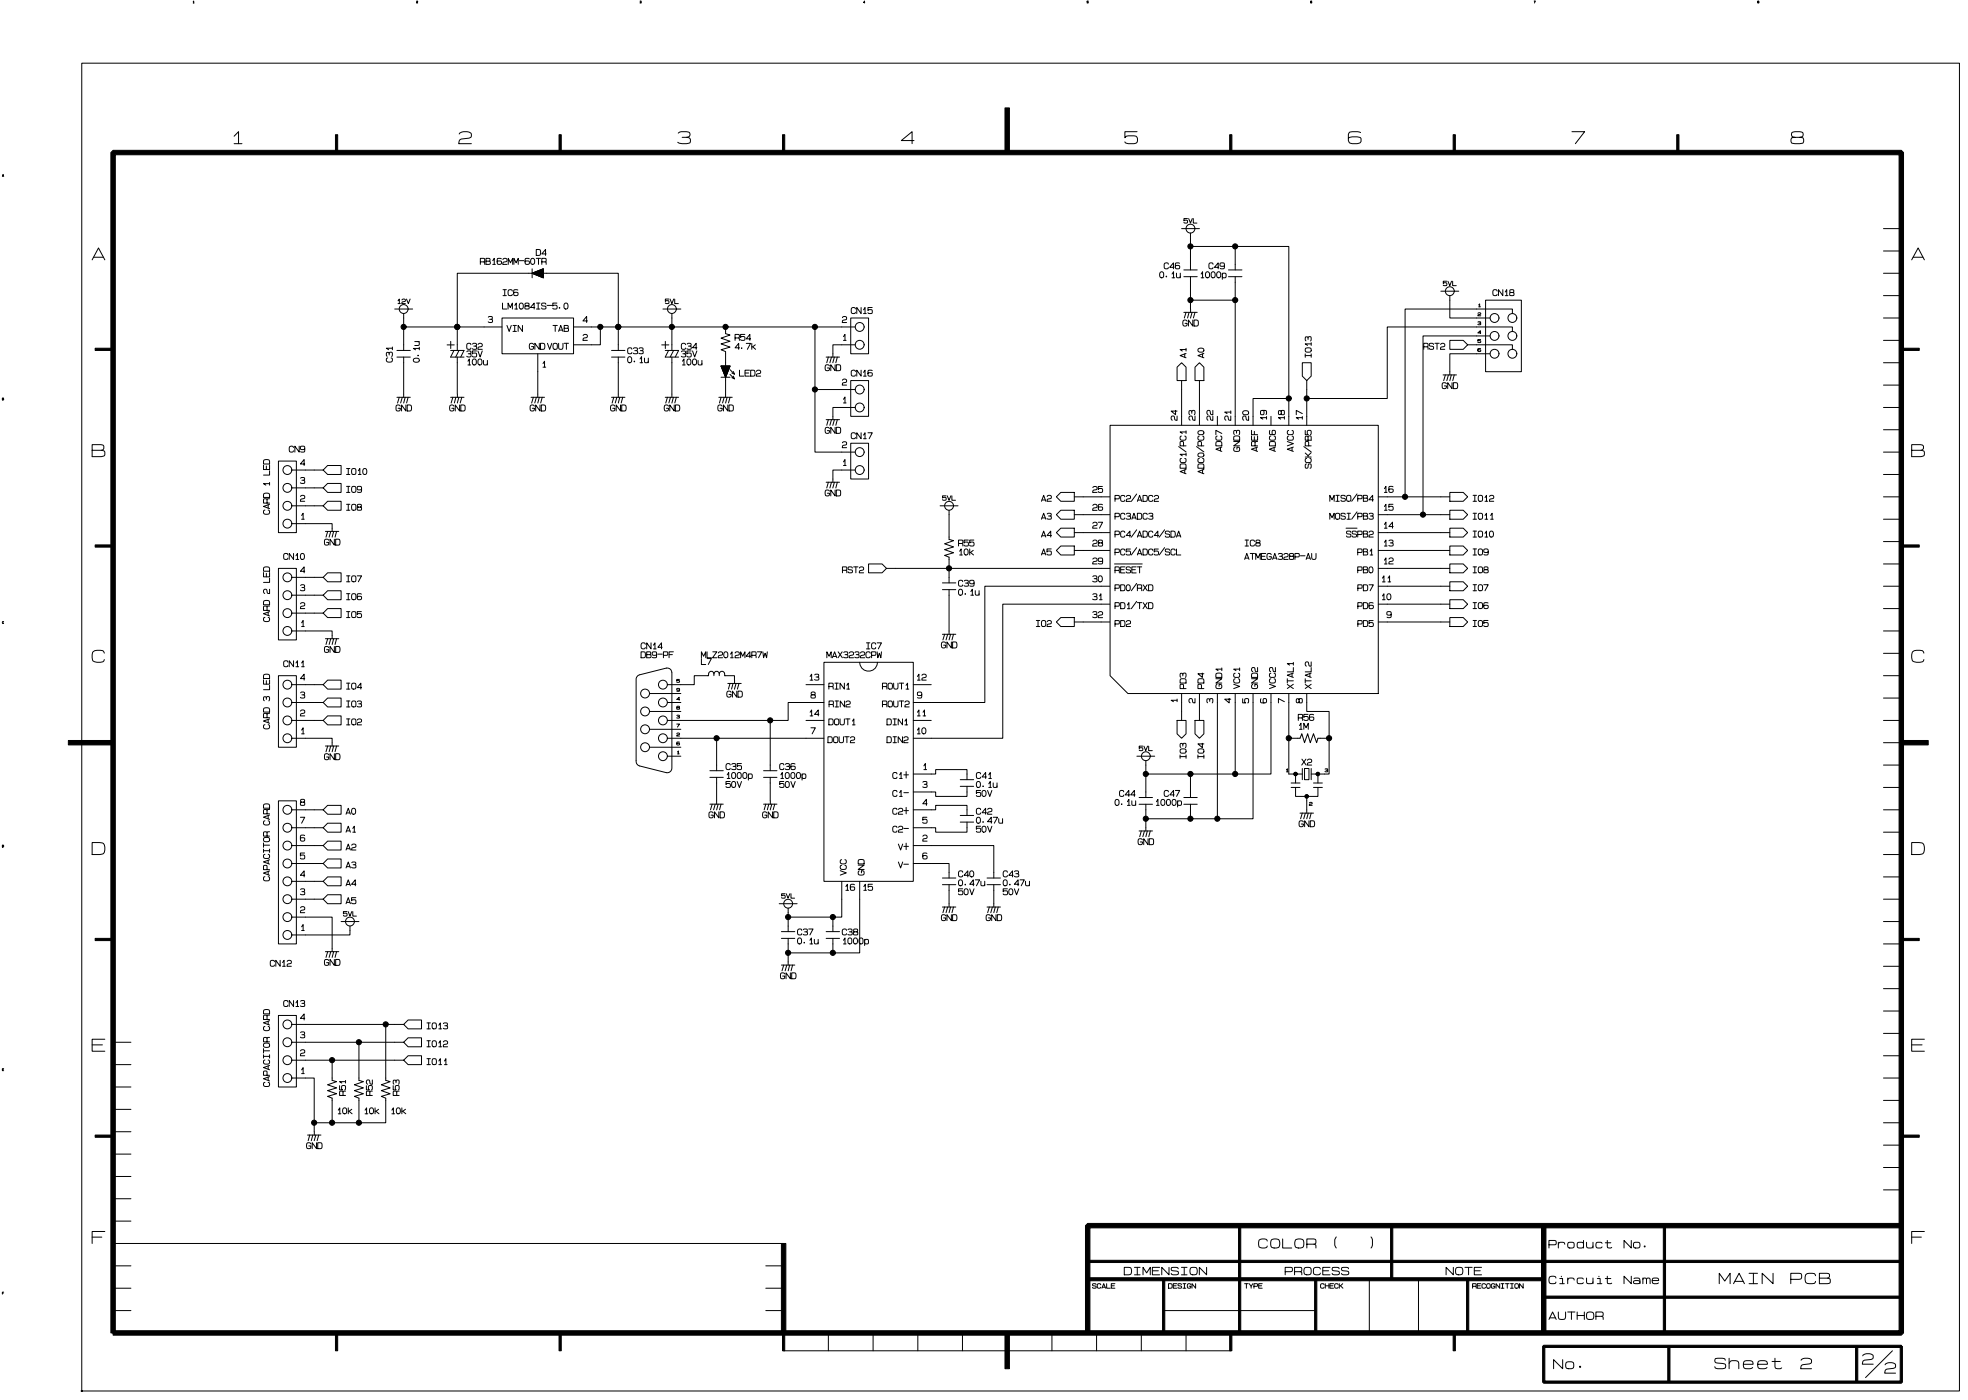
[picture p7: page 2]
