leevawns/WHC512/PCB DESIGN BY A.CHUNG/Wire harness schematic/CARD CAPACITOR.pdf

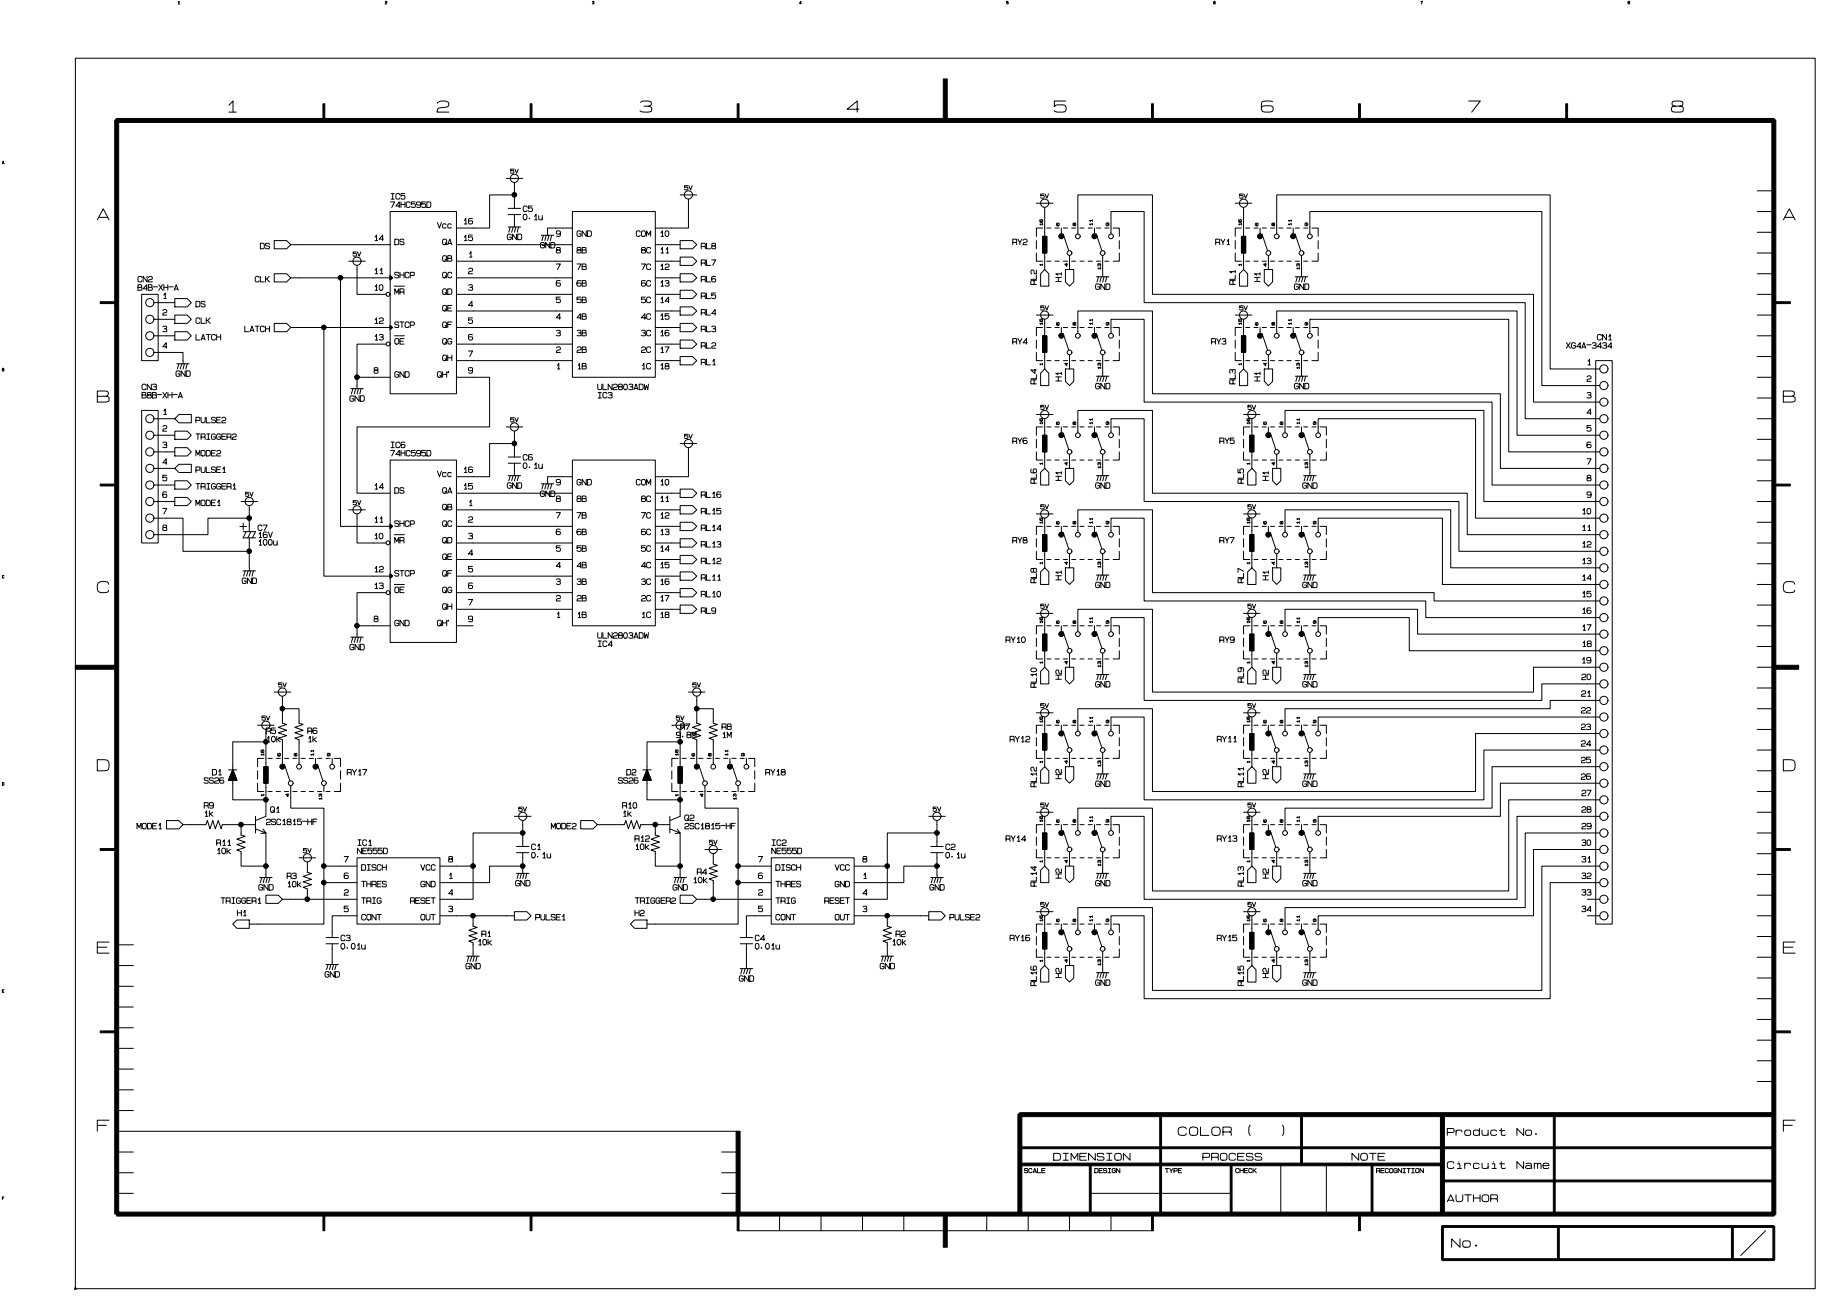
[picture p8: page 1]
