leevawns/WHC512/PCB DESIGN BY A.CHUNG/Wire harness schematic/CARD IO 64BIT.pdf

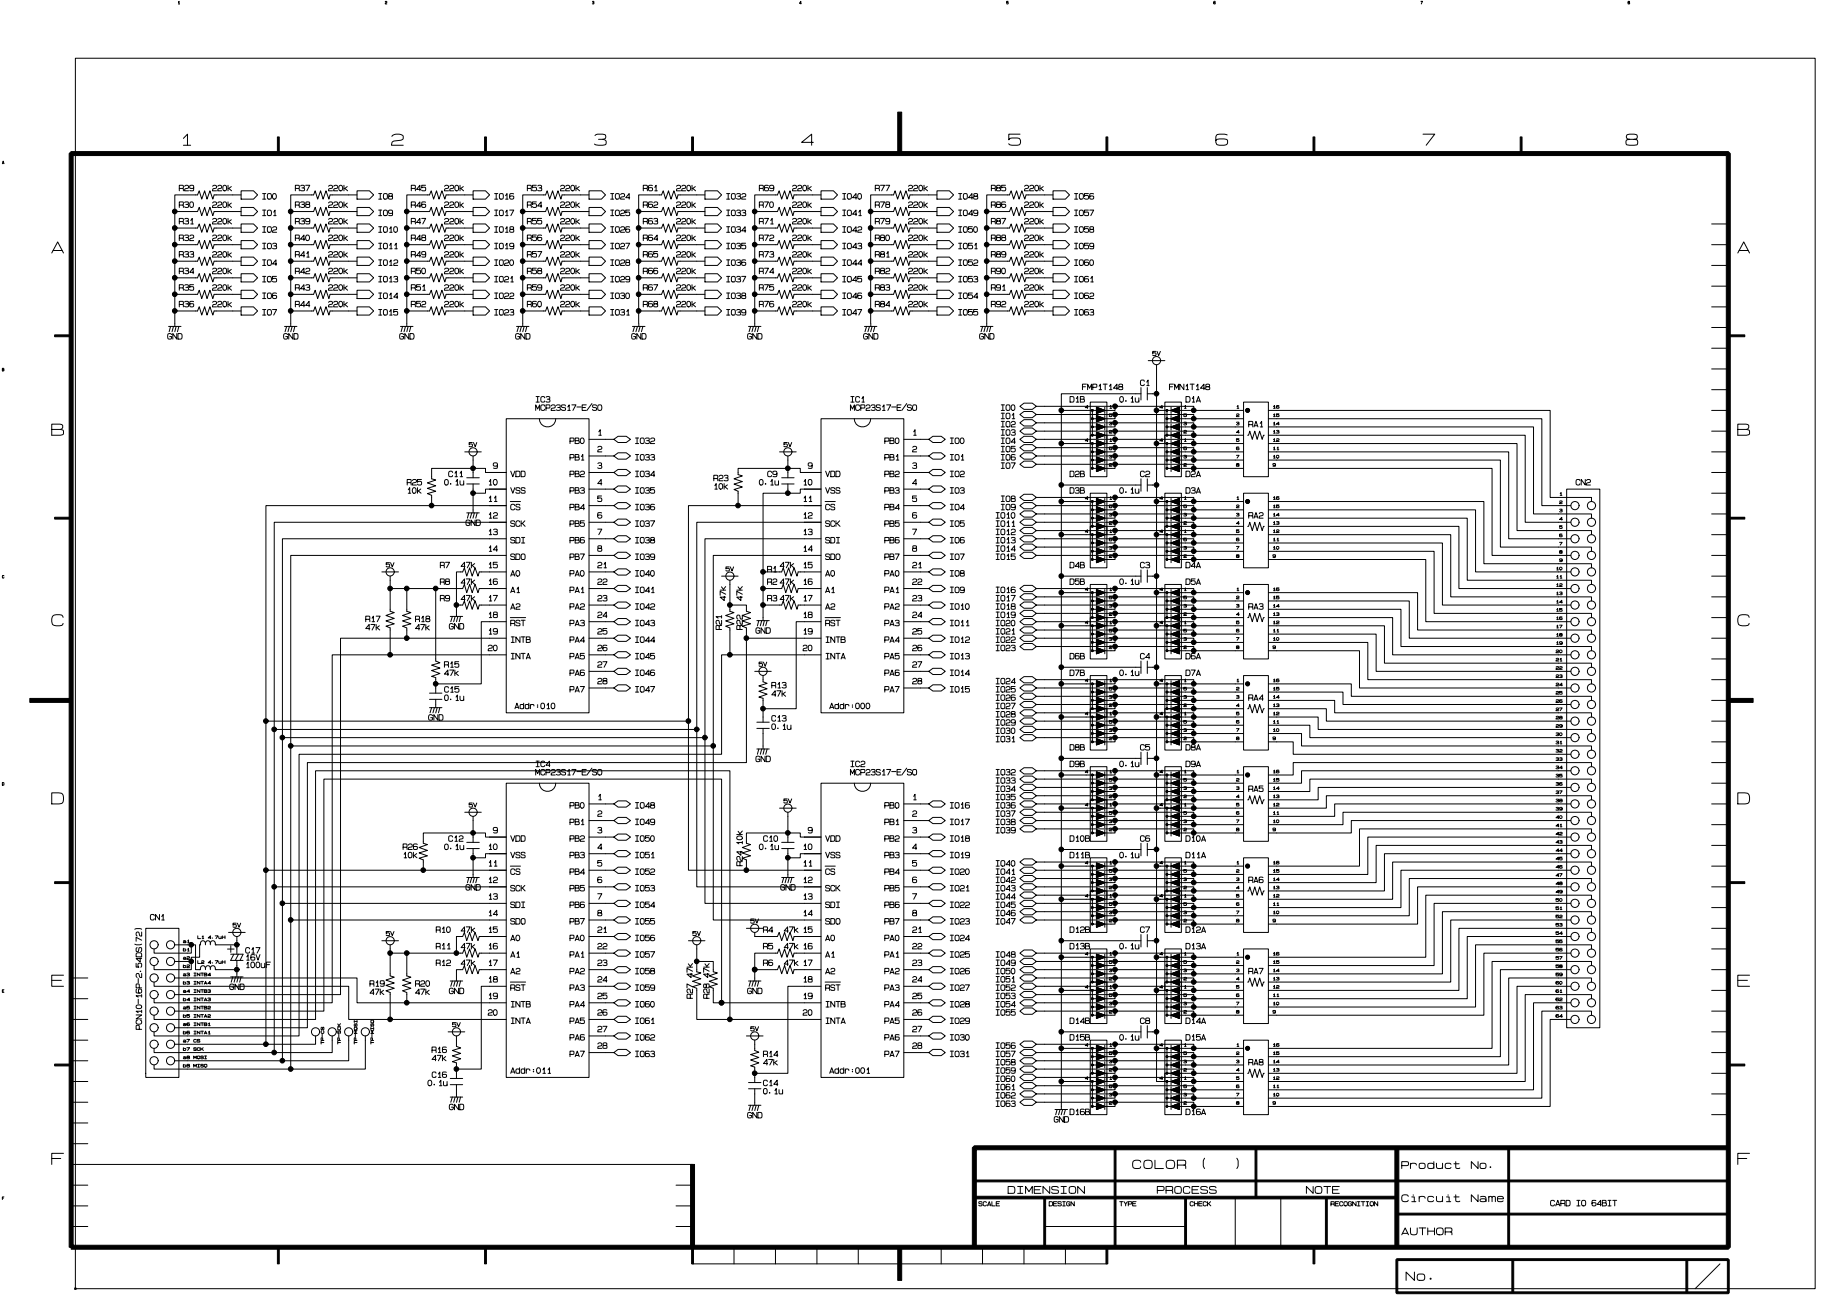
[picture p9: page 1]
