leevawns/WHC512/PCB DESIGN BY A.CHUNG/Wire harness schematic/CARD LED.pdf

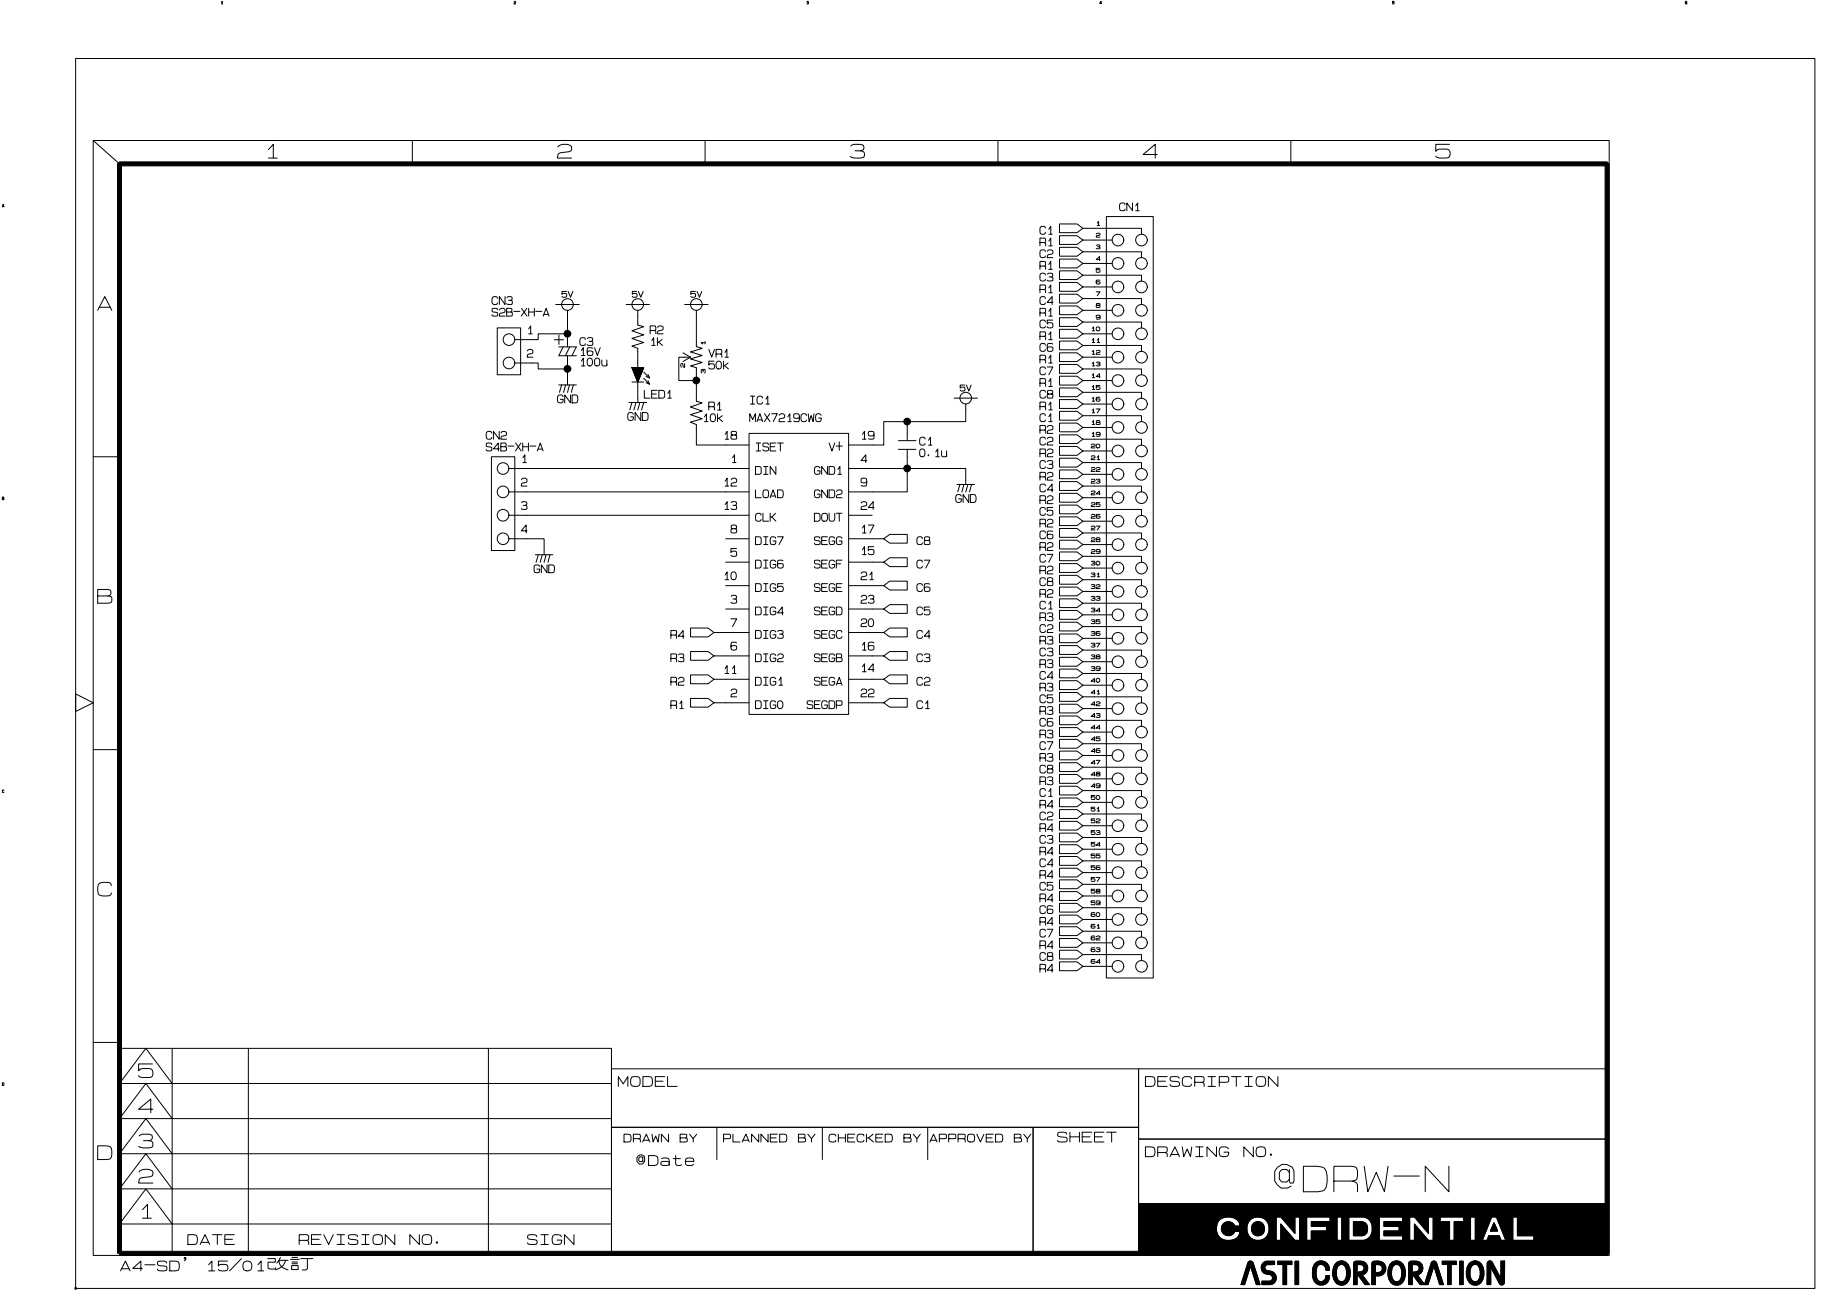
[picture p10: page 1]
