leevawns/WHC512/PCB DESIGN BY A.CHUNG/Wire harness schematic/CONNECTION PCB.pdf

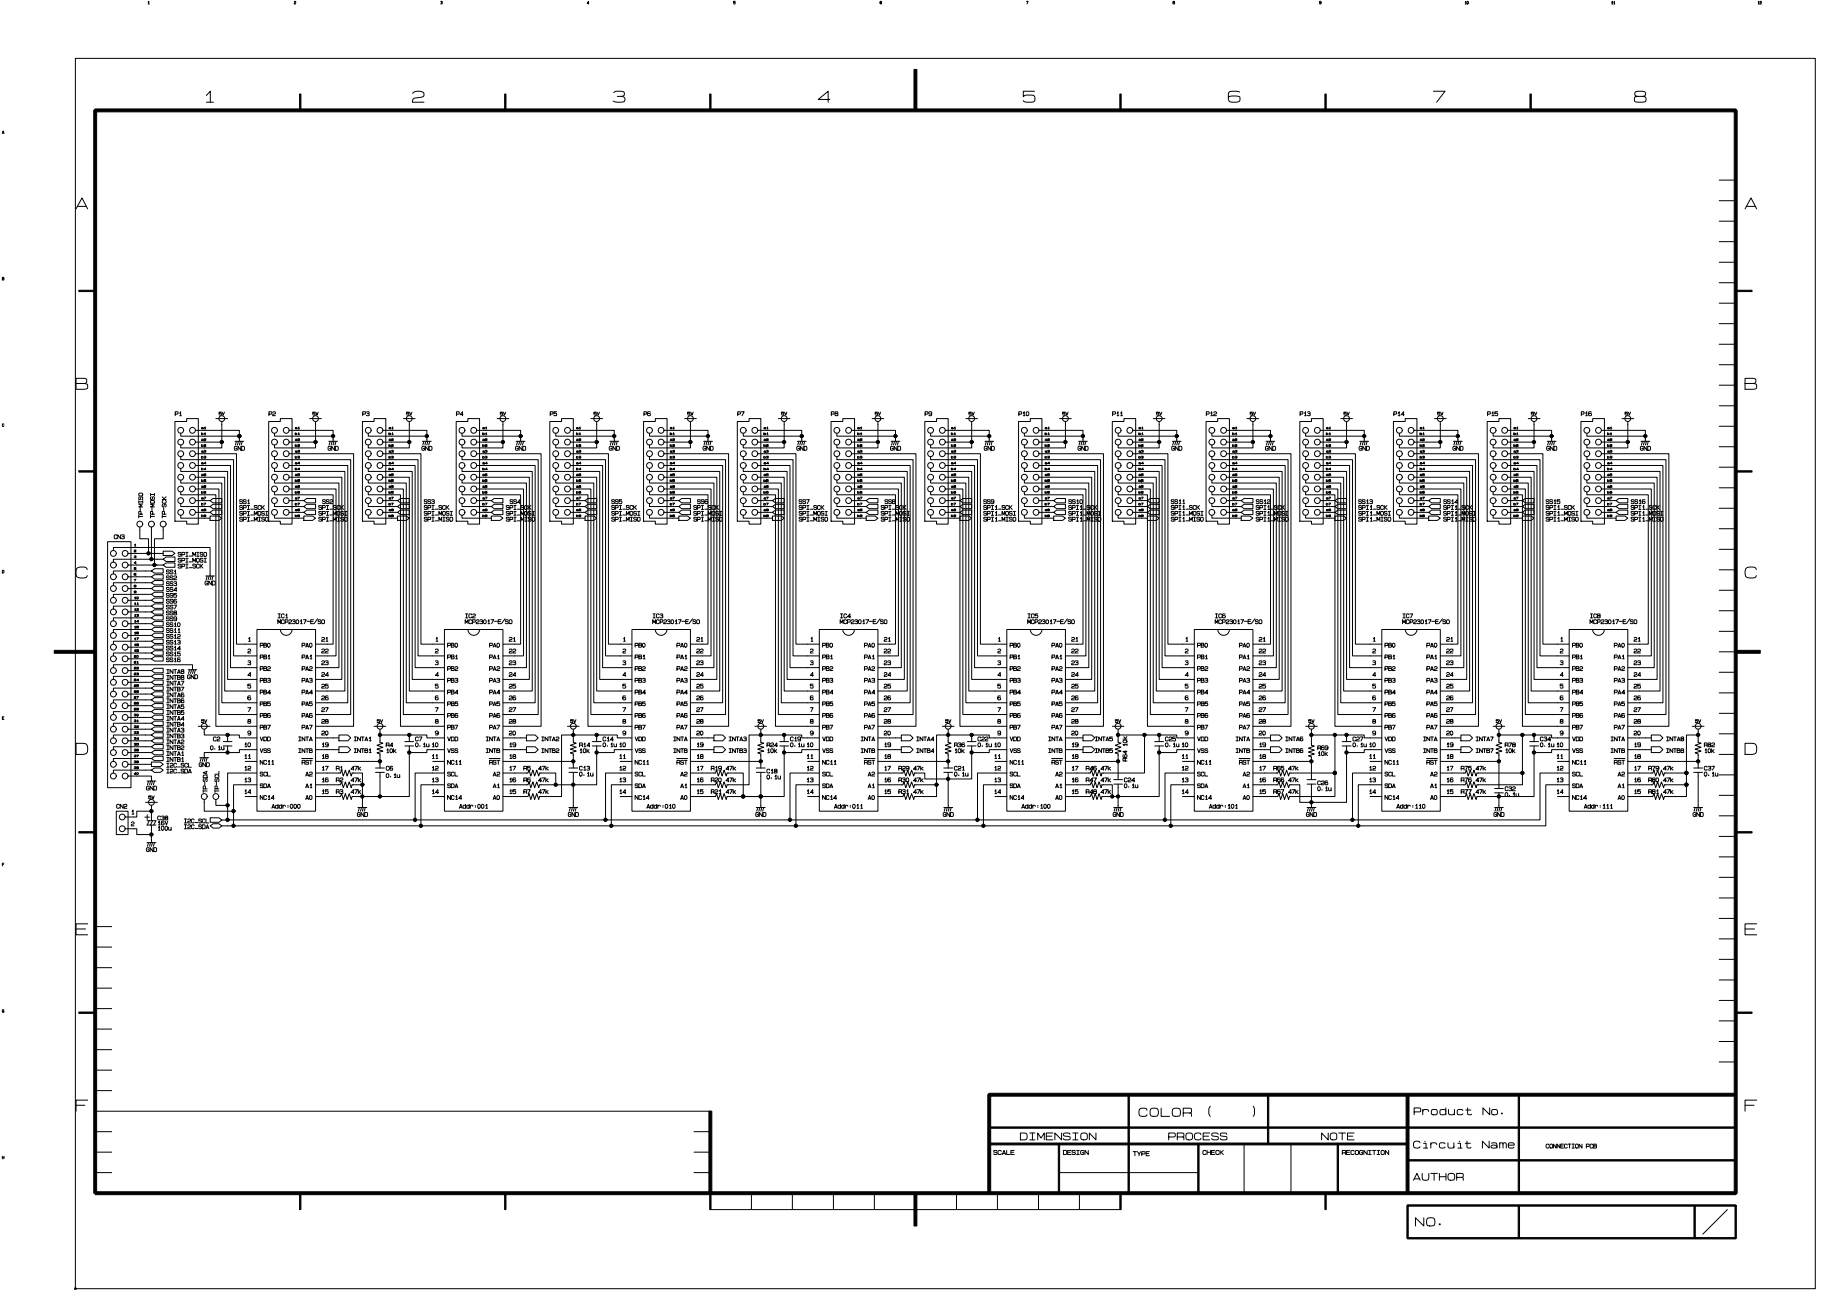
[picture p11: page 1]
