leevawns/WHC512/PCB DESIGN BY A.CHUNG/Wire harness schematic/SUB PCB.pdf

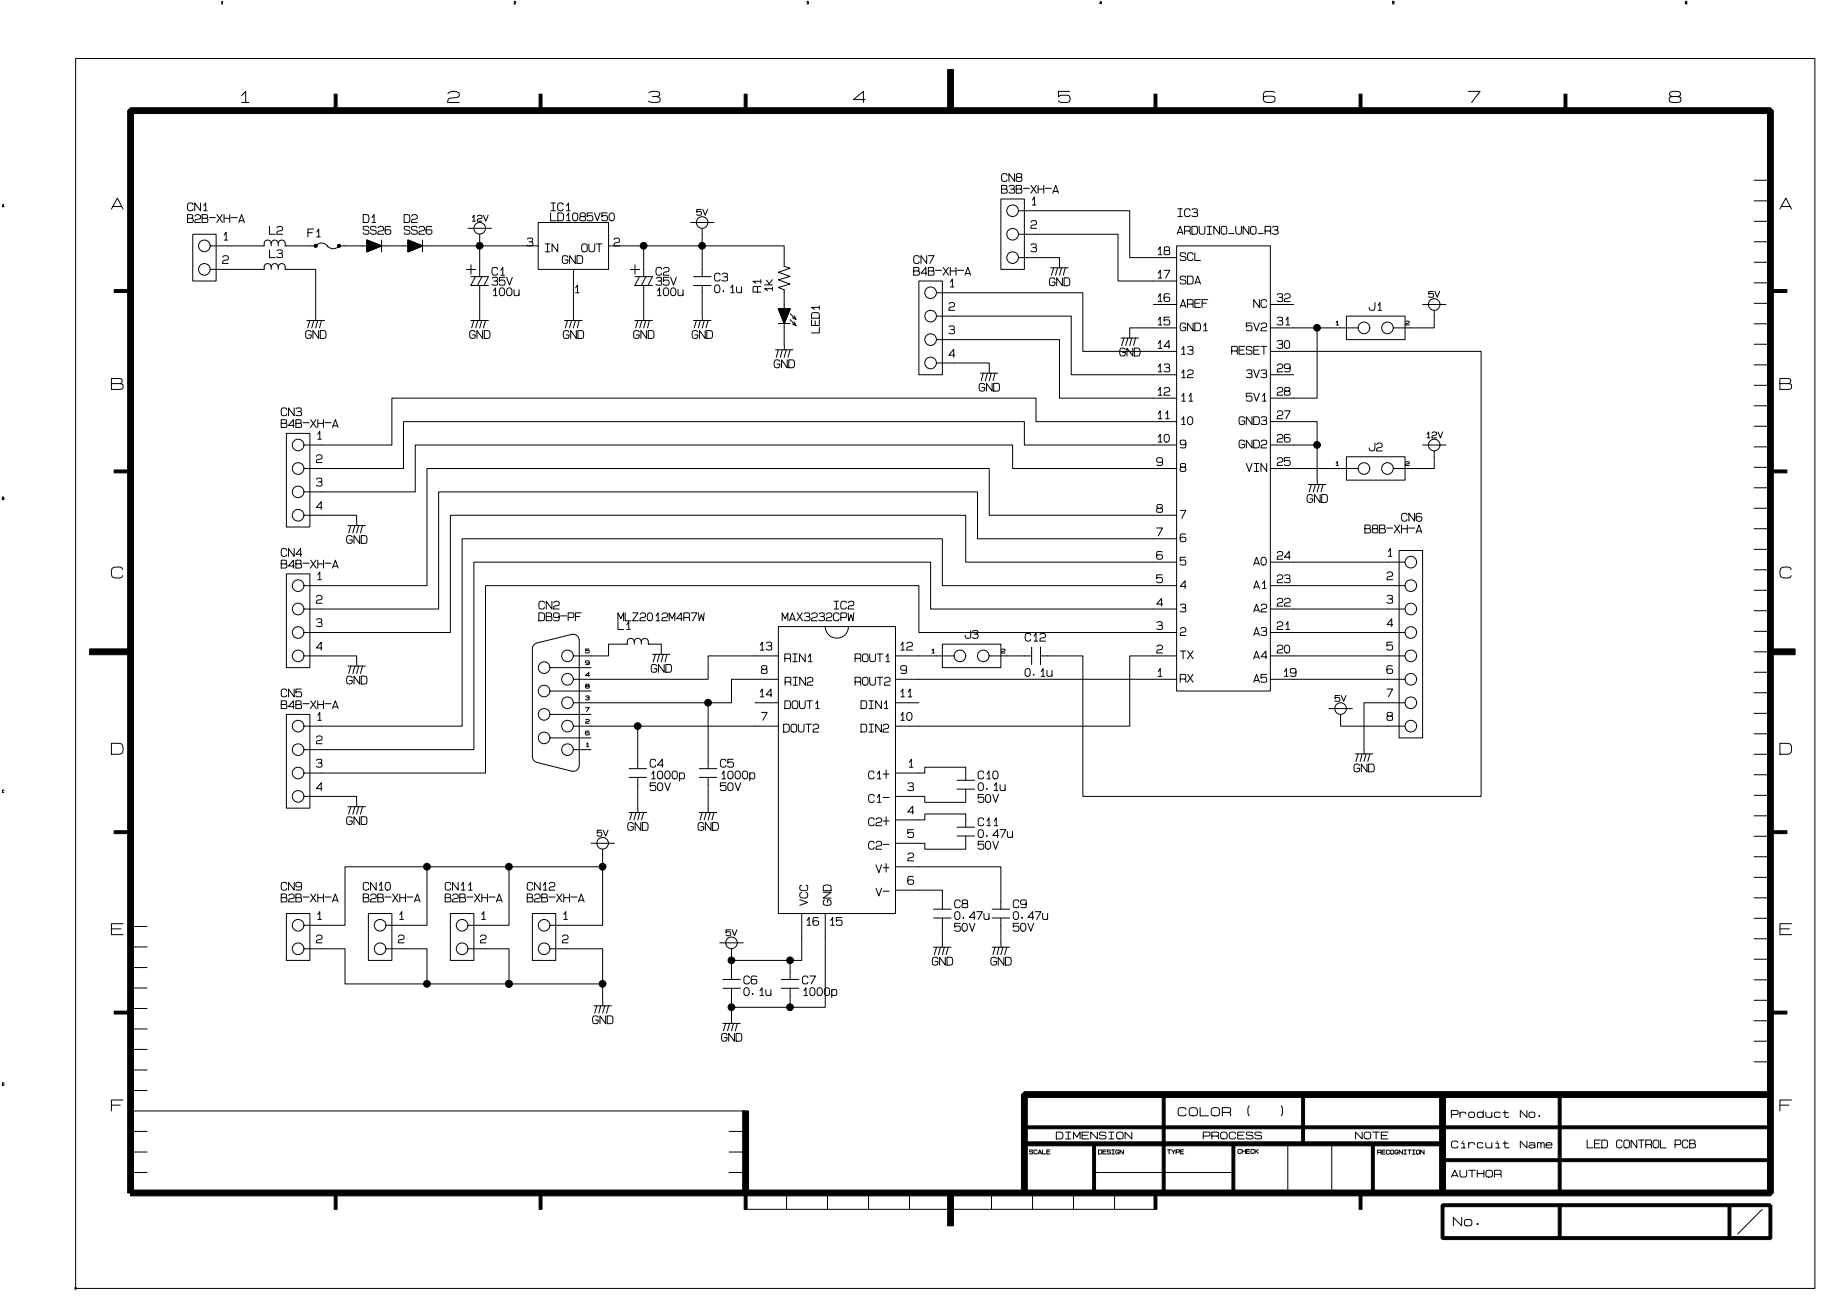
[picture p12: page 1]
