leevawns/WHC512/main_v10/warehanessfunction.h

#ifndef _warehanessfunction_h
#define _warehanessfunction_h

#include "MCP23S17.h"
#include "MCP23017.h"
#include "define_variable.h"
#include <arduino.h>
/*ALL FUNCTION
 * 
 * void init_chip(void): init begin() function for chip mcp
 * void Set_Input_All(void):Set input model for chip mcp
 * void blinkLED(void): bink led
 * void TAPE_OUTPUT(void): Tape out
 * void  SEARCH_ENABLE(void): enable search pin
 * void  SEARCH_DISABLE(void): disable search pin
 *  void BUZZER_OUT1(void): out buzzer 1
 *  void BUZZER_OUT3(void): out buzzer 2
 *  void scandata(void): scan data
 *  void test_ic(void): test ic
 *  void setport(int port): set port to output mode and high level
 *  void clearport(int port): set port to low and input mode
 *  void clear_data(): delete data[]
 *  String check(): return string: ex: 1=2= or e=
 *  String bcc_calculate(String str): return str+bcc
 *  bool bcc_test(String str): test bcc in str,return true if bcc ok and false if bcc fail, str format: string<bcc><\n>, this is bcc 1 byte, ex: "S1X\n", x is 1 byte bcc.
 */
/*RESET ALL I/O TO INPUT MODEL*/
void Set_Input_All(void){
  chip1.pinMode(INPUT);chip2.pinMode(INPUT);chip3.pinMode(INPUT);chip4.pinMode(INPUT);
  chip5.pinMode(INPUT);chip6.pinMode(INPUT);chip7.pinMode(INPUT);chip8.pinMode(INPUT);
  chip9.pinMode(INPUT);chip10.pinMode(INPUT);chip11.pinMode(INPUT);chip12.pinMode(INPUT);
  chip13.pinMode(INPUT);chip14.pinMode(INPUT);chip15.pinMode(INPUT);chip16.pinMode(INPUT);
  chip17.pinMode(INPUT);chip18.pinMode(INPUT);chip19.pinMode(INPUT);chip20.pinMode(INPUT);
  chip21.pinMode(INPUT);chip22.pinMode(INPUT);chip23.pinMode(INPUT);chip24.pinMode(INPUT);
  chip25.pinMode(INPUT);chip26.pinMode(INPUT);chip27.pinMode(INPUT);chip28.pinMode(INPUT);
  chip29.pinMode(INPUT);chip30.pinMode(INPUT);chip31.pinMode(INPUT);chip32.pinMode(INPUT);
}  
/*init all mcp23s17 chip*/
void init_chip(void){
  chip1.begin();chip2.begin();chip3.begin();chip4.begin();
  chip5.begin();chip6.begin();chip7.begin();chip8.begin();
  chip9.begin();chip10.begin();chip11.begin();chip12.begin();
  chip13.begin();chip14.begin();chip15.begin();chip16.begin();
  chip17.begin();chip18.begin();chip19.begin();chip20.begin();
  chip21.begin();chip22.begin();chip23.begin();chip24.begin();
  chip25.begin();chip26.begin();chip27.begin();chip28.begin();
  chip29.begin();chip30.begin();chip31.begin();chip32.begin();
  //set all chip mcp23s17
  Set_Input_All();    //Mr.Chung 3/11/2017
}
/**/
void init_chip_sub(void){
  chip_sub_1.begin();
  chip_sub_2.begin();
  chip_sub_3.begin();
  chip_sub_4.begin();
  }
/**/
void blinkLED(void){
  for (uint8_t i = 0; i<5; i++)
  {
    digitalWrite (LED, HIGH);   delay(100);
    digitalWrite (LED, LOW);    delay(100);
  }
}
/*control Tape*/
void TAPE_OUTPUT(void){
  digitalWrite (TAPE, LOW);
  delay(150);
  digitalWrite (TAPE, HIGH);  
}
/*SEARCH FUNCTION*/
void  SEARCH_ENABLE(void){
  //digitalWrite (SEARCH_EN, LOW);
  digitalWrite (SEARCH_EN, HIGH);
}
/**/
void  SEARCH_DISABLE(void){
  //digitalWrite (SEARCH_EN, HIGH);
  digitalWrite (SEARCH_EN, LOW);
}
/*CHUONG TRINH BUZZER*/
void BUZZER_OUT1(void){
      //tone(BUZZER, frequency, duration);
      digitalWrite (BUZZER, LOW); 
      delay(500);
      digitalWrite (BUZZER,HIGH);
 }
/**/
void BUZZER_OUT3(void){
      digitalWrite (BUZZER, LOW);    delay(500);
      digitalWrite (BUZZER,HIGH);    delay(100);
      digitalWrite (BUZZER, LOW);    delay(500);
      digitalWrite (BUZZER,HIGH);    delay(100);
      digitalWrite (BUZZER, LOW);    delay(500);
      digitalWrite (BUZZER,HIGH);    delay(100);
      //wdt_reset();
      /*
      tone(BUZZER, frequency, duration);delay(150);
      tone(BUZZER, frequency, duration);delay(150);
      tone(BUZZER, frequency, duration);delay(150);
      digitalWrite (BUZZER,HIGH);
      */
 }
/*scan all port save data[31] not use this because wrong command*/
void scandata(void){
for(char i=0;i<32;i++) data[i]=0xffff;//run
uint8_t read_sub_chip=0;
if(!digitalRead(CARD_1)){
   read_sub_chip=chip_sub_1.byteRead(MCP23017_GPIOB);
   if((read_sub_chip&0x03)!=0x03)   if(chip1.byteRead(IOCON)==0b00001000) data[0]=chip1.digitalRead();
   if((read_sub_chip&0x0C)!=0x0C)   if(chip2.byteRead(IOCON)==0b00001000) data[1]=chip2.digitalRead();
   if((read_sub_chip&0x30)!=0x30)   if(chip3.byteRead(IOCON)==0b00001000) data[2]=chip3.digitalRead();
   if((read_sub_chip&0xC0)!=0xC0)   if(chip4.byteRead(IOCON)==0b00001000) data[3]=chip4.digitalRead();
   }
if(!digitalRead(CARD_2)){  
   read_sub_chip=chip_sub_1.byteRead(MCP23017_GPIOA); 
   if((read_sub_chip&0x03)!=0x03) if(chip5.byteRead(IOCON)==0b00001000) data[4]=chip5.digitalRead();
   if((read_sub_chip&0x0C)!=0x0C) if(chip6.byteRead(IOCON)==0b00001000) data[5]=chip6.digitalRead();
   if((read_sub_chip&0x30)!=0x30) if(chip7.byteRead(IOCON)==0b00001000) data[6]=chip7.digitalRead();
   if((read_sub_chip&0xC0)!=0xC0) if(chip8.byteRead(IOCON)==0b00001000) data[7]=chip8.digitalRead();
   }
if(!digitalRead(CARD_3)){ 
   read_sub_chip=chip_sub_2.byteRead(MCP23017_GPIOB); 
   if((read_sub_chip&0x03)!=0x03)if(chip9.byteRead(IOCON)==0b00001000) data[8]=chip9.digitalRead();
   if((read_sub_chip&0x0C)!=0x0C)if(chip10.byteRead(IOCON)==0b00001000) data[9]=chip10.digitalRead();
   if((read_sub_chip&0x30)!=0x30)if(chip11.byteRead(IOCON)==0b00001000) data[10]=chip11.digitalRead();
   if((read_sub_chip&0xC0)!=0xC0)if(chip12.byteRead(IOCON)==0b00001000) data[11]=chip12.digitalRead();
   }
if(!digitalRead(CARD_4)){  
   read_sub_chip=chip_sub_2.byteRead(MCP23017_GPIOA);  
   if((read_sub_chip&0x03)!=0x03) if(chip13.byteRead(IOCON)==0b00001000) data[12]=chip13.digitalRead();
   if((read_sub_chip&0x0C)!=0x0C) if(chip14.byteRead(IOCON)==0b00001000) data[13]=chip14.digitalRead();
   if((read_sub_chip&0x30)!=0x30) if(chip15.byteRead(IOCON)==0b00001000) data[14]=chip15.digitalRead();
   if((read_sub_chip&0xC0)!=0xC0) if(chip16.byteRead(IOCON)==0b00001000) data[15]=chip16.digitalRead();
   }
if(!digitalRead(CARD_5)){
   read_sub_chip=chip_sub_3.byteRead(MCP23017_GPIOB);
   if((read_sub_chip&0x03)!=0x03) if(chip17.byteRead(IOCON)==0b00001000) data[16]=chip17.digitalRead();
   if((read_sub_chip&0x0C)!=0x0C) if(chip18.byteRead(IOCON)==0b00001000) data[17]=chip18.digitalRead();
   if((read_sub_chip&0x30)!=0x30) if(chip19.byteRead(IOCON)==0b00001000) data[18]=chip19.digitalRead();
   if((read_sub_chip&0xC0)!=0xC0) if(chip20.byteRead(IOCON)==0b00001000) data[19]=chip20.digitalRead();
   }
if(!digitalRead(CARD_6)){
   read_sub_chip=chip_sub_3.byteRead(MCP23017_GPIOA);
   if((read_sub_chip&0x03)!=0x03) if(chip21.byteRead(IOCON)==0b00001000) data[20]=chip21.digitalRead();
   if((read_sub_chip&0x0C)!=0x0C) if(chip22.byteRead(IOCON)==0b00001000) data[21]=chip22.digitalRead();
   if((read_sub_chip&0x30)!=0x30) if(chip23.byteRead(IOCON)==0b00001000) data[22]=chip23.digitalRead();
   if((read_sub_chip&0xC0)!=0xC0) if(chip24.byteRead(IOCON)==0b00001000) data[23]=chip24.digitalRead();
   }
if(!digitalRead(CARD_7)){
   read_sub_chip=chip_sub_4.byteRead(MCP23017_GPIOB);
   if((read_sub_chip&0x03)!=0x03) if(chip25.byteRead(IOCON)==0b00001000) data[24]=chip25.digitalRead();
   if((read_sub_chip&0x0C)!=0x0C) if(chip26.byteRead(IOCON)==0b00001000) data[25]=chip26.digitalRead();
   if((read_sub_chip&0x30)!=0x30) if(chip27.byteRead(IOCON)==0b00001000) data[26]=chip27.digitalRead();
   if((read_sub_chip&0xC0)!=0xC0) if(chip28.byteRead(IOCON)==0b00001000) data[27]=chip28.digitalRead();
   }
if(!digitalRead(CARD_8)){
   read_sub_chip=chip_sub_4.byteRead(MCP23017_GPIOA);
   if((read_sub_chip&0x03)!=0x03) if(chip29.byteRead(IOCON)==0b00001000) data[28]=chip29.digitalRead();
   if((read_sub_chip&0x0C)!=0x0C) if(chip30.byteRead(IOCON)==0b00001000) data[29]=chip30.digitalRead();
   if((read_sub_chip&0x30)!=0x30) if(chip31.byteRead(IOCON)==0b00001000) data[30]=chip31.digitalRead();
   if((read_sub_chip&0xC0)!=0xC0) if(chip32.byteRead(IOCON)==0b00001000) data[31]=chip32.digitalRead();
   }}
/**/
/*scan all port save data[31] use interrupt*/
void scandata_2(void){
for(char i=0;i<32;i++) data[i]=0xffff;//run
uint8_t read_sub_chip=0;
if(!digitalRead(CARD_1)){
   read_sub_chip=chip_sub_1.byteRead(MCP23017_GPIOB);
   if((read_sub_chip&0xC0)!=0xC0)   if(chip1.byteRead(IOCON)==0b00001000) data[0]=chip1.digitalRead();
   if((read_sub_chip&0x30)!=0x30)   if(chip2.byteRead(IOCON)==0b00001000) data[1]=chip2.digitalRead();
   if((read_sub_chip&0x0C)!=0x0C)   if(chip3.byteRead(IOCON)==0b00001000) data[2]=chip3.digitalRead();
   if((read_sub_chip&0x03)!=0x03)   if(chip4.byteRead(IOCON)==0b00001000) data[3]=chip4.digitalRead();
   }
if(!digitalRead(CARD_2)){  
   read_sub_chip=chip_sub_1.byteRead(MCP23017_GPIOA); 
   if((read_sub_chip&0xC0)!=0xC0) if(chip5.byteRead(IOCON)==0b00001000) data[4]=chip5.digitalRead();
   if((read_sub_chip&0x30)!=0x30) if(chip6.byteRead(IOCON)==0b00001000) data[5]=chip6.digitalRead();
   if((read_sub_chip&0x0C)!=0x0C) if(chip7.byteRead(IOCON)==0b00001000) data[6]=chip7.digitalRead();
   if((read_sub_chip&0x03)!=0x03) if(chip8.byteRead(IOCON)==0b00001000) data[7]=chip8.digitalRead();
   }
if(!digitalRead(CARD_3)){ 
   read_sub_chip=chip_sub_2.byteRead(MCP23017_GPIOB); 
   if((read_sub_chip&0xC0)!=0xC0)if(chip9.byteRead(IOCON)==0b00001000) data[8]=chip9.digitalRead();
   if((read_sub_chip&0x30)!=0x30)if(chip10.byteRead(IOCON)==0b00001000) data[9]=chip10.digitalRead();
   if((read_sub_chip&0x0C)!=0x0C)if(chip11.byteRead(IOCON)==0b00001000) data[10]=chip11.digitalRead();
   if((read_sub_chip&0x03)!=0x03)if(chip12.byteRead(IOCON)==0b00001000) data[11]=chip12.digitalRead();
   }
if(!digitalRead(CARD_4)){  
   read_sub_chip=chip_sub_2.byteRead(MCP23017_GPIOA);  
   if((read_sub_chip&0xC0)!=0xC0) if(chip13.byteRead(IOCON)==0b00001000) data[12]=chip13.digitalRead();
   if((read_sub_chip&0x30)!=0x30) if(chip14.byteRead(IOCON)==0b00001000) data[13]=chip14.digitalRead();
   if((read_sub_chip&0x0C)!=0x0C) if(chip15.byteRead(IOCON)==0b00001000) data[14]=chip15.digitalRead();
   if((read_sub_chip&0x03)!=0x03) if(chip16.byteRead(IOCON)==0b00001000) data[15]=chip16.digitalRead();
   }
if(!digitalRead(CARD_5)){
   read_sub_chip=chip_sub_3.byteRead(MCP23017_GPIOB);
   if((read_sub_chip&0xC0)!=0xC0) if(chip17.byteRead(IOCON)==0b00001000) data[16]=chip17.digitalRead();
   if((read_sub_chip&0x30)!=0x30) if(chip18.byteRead(IOCON)==0b00001000) data[17]=chip18.digitalRead();
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
   if(chip30.byteRead(IOCON)==0b00001000) data[29]=chip30.digitalRead();
   if(chip31.byteRead(IOCON)==0b00001000) data[30]=chip31.digitalRead();
   if(chip32.byteRead(IOCON)==0b00001000) data[31]=chip32.digitalRead();
   if(chip25.byteRead(IOCON)==0b00001000) data[24]=chip25.digitalRead();
   if(chip26.byteRead(IOCON)==0b00001000) data[25]=chip26.digitalRead();
   if(chip27.byteRead(IOCON)==0b00001000) data[26]=chip27.digitalRead();
   if(chip28.byteRead(IOCON)==0b00001000) data[27]=chip28.digitalRead();
   }
}
/*scan all port save data[31] not use interrupt*/
void scandata_1(void){
for(char i=0;i<32;i++) data[i]=0XFFFF;//run
if(chip1.byteRead(IOCON)==0b00001000) data[0]=chip1.digitalRead();
if(chip2.byteRead(IOCON)==0b00001000) data[1]=chip2.digitalRead();
if(chip3.byteRead(IOCON)==0b00001000) data[2]=chip3.digitalRead();
if(chip4.byteRead(IOCON)==0b00001000) data[3]=chip4.digitalRead();
if(chip5.byteRead(IOCON)==0b00001000) data[4]=chip5.digitalRead();
if(chip6.byteRead(IOCON)==0b00001000) data[5]=chip6.digitalRead();
if(chip7.byteRead(IOCON)==0b00001000) data[6]=chip7.digitalRead();
if(chip8.byteRead(IOCON)==0b00001000) data[7]=chip8.digitalRead();
if(chip9.byteRead(IOCON)==0b00001000) data[8]=chip9.digitalRead();
if(chip10.byteRead(IOCON)==0b00001000) data[9]=chip10.digitalRead();
if(chip11.byteRead(IOCON)==0b00001000) data[10]=chip11.digitalRead();
if(chip12.byteRead(IOCON)==0b00001000) data[11]=chip12.digitalRead();
if(chip13.byteRead(IOCON)==0b00001000) data[12]=chip13.digitalRead();
if(chip14.byteRead(IOCON)==0b00001000) data[13]=chip14.digitalRead();
if(chip15.byteRead(IOCON)==0b00001000) data[14]=chip15.digitalRead();
if(chip16.byteRead(IOCON)==0b00001000) data[15]=chip16.digitalRead();
if(chip17.byteRead(IOCON)==0b00001000) data[16]=chip17.digitalRead();
if(chip18.byteRead(IOCON)==0b00001000) data[17]=chip18.digitalRead();
if(chip19.byteRead(IOCON)==0b00001000) data[18]=chip19.digitalRead();
if(chip20.byteRead(IOCON)==0b00001000) data[19]=chip20.digitalRead();
if(chip21.byteRead(IOCON)==0b00001000) data[20]=chip21.digitalRead();
if(chip22.byteRead(IOCON)==0b00001000) data[21]=chip22.digitalRead();
if(chip23.byteRead(IOCON)==0b00001000) data[22]=chip23.digitalRead();
if(chip24.byteRead(IOCON)==0b00001000) data[23]=chip24.digitalRead();
if(chip25.byteRead(IOCON)==0b00001000) data[24]=chip25.digitalRead();
if(chip26.byteRead(IOCON)==0b00001000) data[25]=chip26.digitalRead();
if(chip27.byteRead(IOCON)==0b00001000) data[26]=chip27.digitalRead();
if(chip28.byteRead(IOCON)==0b00001000) data[27]=chip28.digitalRead();
if(chip29.byteRead(IOCON)==0b00001000) data[28]=chip29.digitalRead();
if(chip30.byteRead(IOCON)==0b00001000) data[29]=chip30.digitalRead();
if(chip31.byteRead(IOCON)==0b00001000) data[30]=chip31.digitalRead();
if(chip32.byteRead(IOCON)==0b00001000) data[31]=chip32.digitalRead();}
/**/
void setport(unsigned int port){
  id_card = (port-1)/64;
  id_ic = ((port-1)%64)/16;
  id_pin = (((port-1)%64)%16)+1;
  switch (id_card){
    case 0: 
      switch(id_ic){
        case 0: chip1.pinMode(id_pin,OUTPUT); chip1.digitalWrite(id_pin,LOW);
                 break;
        case 1: chip2.pinMode(id_pin,OUTPUT); chip2.digitalWrite(id_pin,LOW);
                 break;
        case 2: chip3.pinMode(id_pin,OUTPUT); chip3.digitalWrite(id_pin,LOW);
                 break;
        case 3: chip4.pinMode(id_pin,OUTPUT); chip4.digitalWrite(id_pin,LOW);
                break;

      default:
         break;
        }
     break;   
    case 1:
      switch(id_ic){
      case 0: chip5.pinMode(id_pin,OUTPUT); chip5.digitalWrite(id_pin,LOW);
               break;
      case 1: chip6.pinMode(id_pin,OUTPUT); chip6.digitalWrite(id_pin,LOW);
               break;
      case 2: chip7.pinMode(id_pin,OUTPUT); chip7.digitalWrite(id_pin,LOW);
               break;
      case 3: chip8.pinMode(id_pin,OUTPUT); chip8.digitalWrite(id_pin,LOW);
         break;
      default:
         break;    
    }
    break;
    case 2:
      switch(id_ic){
      case 0: chip9.pinMode(id_pin,OUTPUT); chip9.digitalWrite(id_pin,LOW);
               break;
      case 1: chip10.pinMode(id_pin,OUTPUT); chip10.digitalWrite(id_pin,LOW);
               break;
      case 2: chip11.pinMode(id_pin,OUTPUT); chip11.digitalWrite(id_pin,LOW);
               break;
      case 3: chip12.pinMode(id_pin,OUTPUT); chip12.digitalWrite(id_pin,LOW);
         break;
        default:
         break;    
    }
    break;
    case 3:
      switch(id_ic){
      case 0: chip13.pinMode(id_pin,OUTPUT); chip13.digitalWrite(id_pin,LOW);
               break;
      case 1: chip14.pinMode(id_pin,OUTPUT); chip14.digitalWrite(id_pin,LOW);
               break;
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
         return 0;break;
  }
}
/**/
void clear_data(){
  for(char i=0;i<32;i++){
      data[i]=0;
      }
}
/**/
bool bcc_check(unsigned char str[]){ 
  unsigned char checksum=0;
  for(int i=0;i<5;i++){
    checksum += str[i];
  }
  if(checksum == str[5])
  {return true; }
  else{return false;}
}
/*return string with  port same level Example: 1=2=3=*/
void check(){
  dem= "";
  for(unsigned int i=0;i<32;i++)
  {
      if(data[i]!=0xffff) for(unsigned int j=0;j<16;j++){if((((~data[i])>>j) & 0x0001)!=0) dem=dem + String(i*16+j+1)+ "=";}   
  }                        
  //return dem;
  }
void check2(){
  dem= "";
  for(unsigned int i=0;i<32;i++)
  {
      if(data[i]!=0xffff) dem=dem+String(i)+"*"+String(~data[i],HEX)+ "=";   
  }                        
  //return dem;
  }
/*save least 2 value in array data_single_port*/
void check_single_port(){
   data_single_port[0]=0;
   data_single_port[1]=0;
   unsigned char k=0;
  for(unsigned char i=0;i<32;i++)
  {
      if(data[i]!=0|k<2) for(unsigned char j=0;j<16;j++){
                                                    if(((data[i]>>j) & 0x0001)!=0){
                                                                                   if(k<2){
                                                                                           data_single_port[k]=i*16+j+1;k+=1;
                                                                                           } else break;
                                                                                   }
                                                    } 
                         else break;
  }
}
void init_interrupts_card(void){
  pinMode(CARD_1,INPUT);
  pinMode(CARD_2,INPUT);
  pinMode(CARD_3,INPUT);
  pinMode(CARD_4,INPUT);
  pinMode(CARD_5,INPUT);
  pinMode(CARD_6,INPUT);
  pinMode(CARD_7,INPUT);
  pinMode(CARD_8,INPUT);
  }

#endif
